lyf8118/sandiaproject/Docs/Report/Final Report/Pictures/IMG_2510.JPG

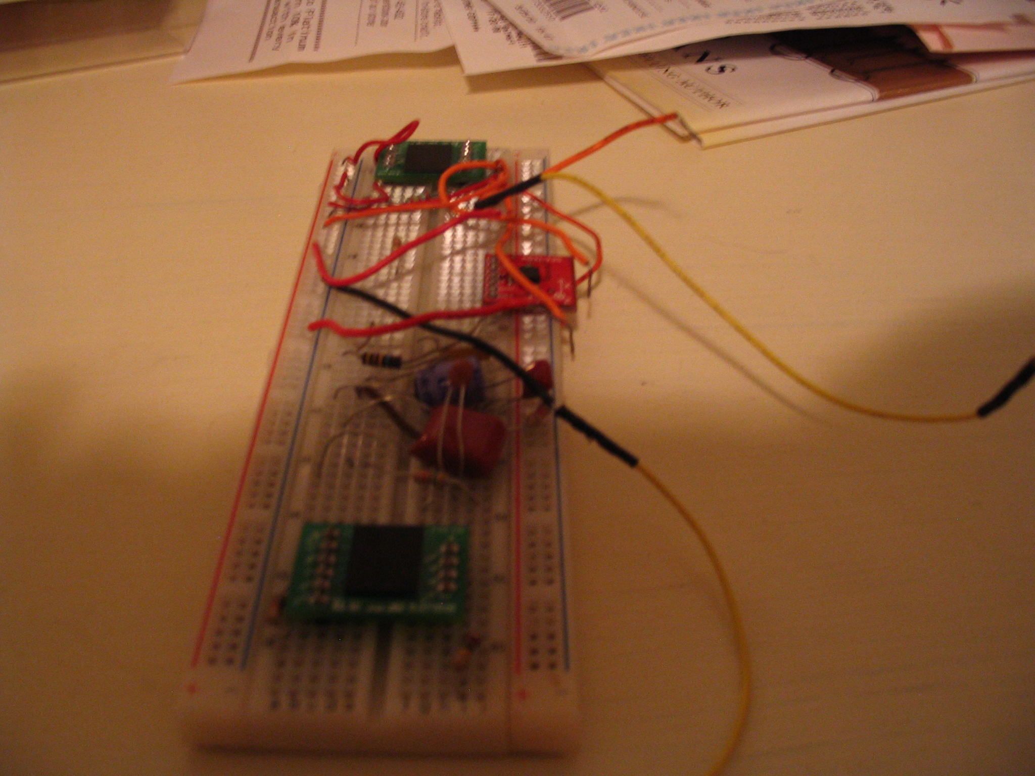
Docs/Report/Final Report/Pictures/IMG_2510.JPG
