lyf8118/sandiaproject/Docs/MSP430F5529 items/README.txt

Go to the following website to get all of the needed software for this processor. The site contains a link for software needed to run in the CCE or Kickstart programs. Make sure to install the software in the directory of your running IDE in order to make it work right.

http://focus.ti.com/docs/prod/folders/print/msp430f5529.html
