lyf8118/sandiaproject/Docs/CDs/Utah 2008-09/Paper/Abstract.docx

TESTING AND RESULTS

Eric Hsu, Daniel Rolfe, Rashin Bolkameh, Chris Chadwick, Michael

Stevens Department of Electrical and Computer Engineering, University of Utah, Salt

Lake City, UT 84112

The first step in our testing phase was to load small instruction sets to the micro controller to verify proper wiring of the board and tested for certain operation such as power, saving data, detecting movement. The testing involved verifying all individual components of our manufactured GPS stack powers up correctly and individual paths are correct in the way we envisioned. Once that phase was completed, we moved into verification logic of accelerometer code that enables and disables GPS data acquisition. One of the major aspects of our operational sequence was the transfer of data from front-end GPS unit to our internal memory and finally outputting these data using serial interface. After we verified the individual modules to be working, we combined them together to ultimately build a single overall operational code for our GPS stack. Extended testing over the GPS stack with its associated results remains the one of the primary objectives of this project.

Socket Error

Voltage Regular Drop

JTAG
