lyf8118/sandiaproject/Docs/CDs/Utah 2008-09/Paper/Visio-GPSrev1.pdf

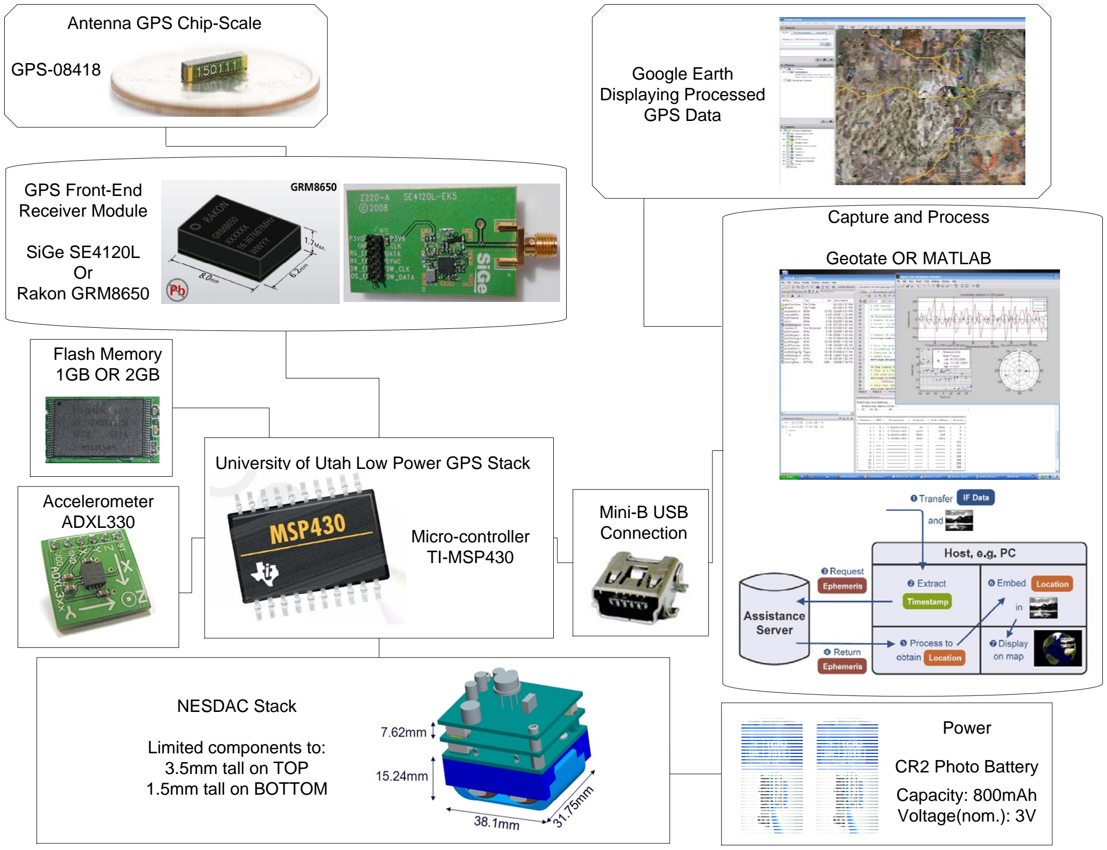
[picture p55: page 1]

Antenna GPS Chip-Scale

GPS-08418

CR2 Photo Battery
Capacity: 800mAh
Voltage(nom.): 3V

Power

NESDAC Stack

Limited components to:
3.5mm tall on TOP
1.5mm tall on BOTTOM

GPS Front-End
Receiver Module

SiGe SE4120L
Or
Rakon GRM8650

Accelerometer
ADXL330

University of Utah Low Power GPS Stack

Micro-controller
TI-MSP430

Flash Memory
1GB OR 2GB

Mini-B USB
Connection

Capture and Process

Geotate OR MATLAB

Google Earth
Displaying Processed
GPS Data
