lyf8118/sandiaproject/Docs/CDs/Utah 2008-09/Paper/Visio-GPSrev3.pdf

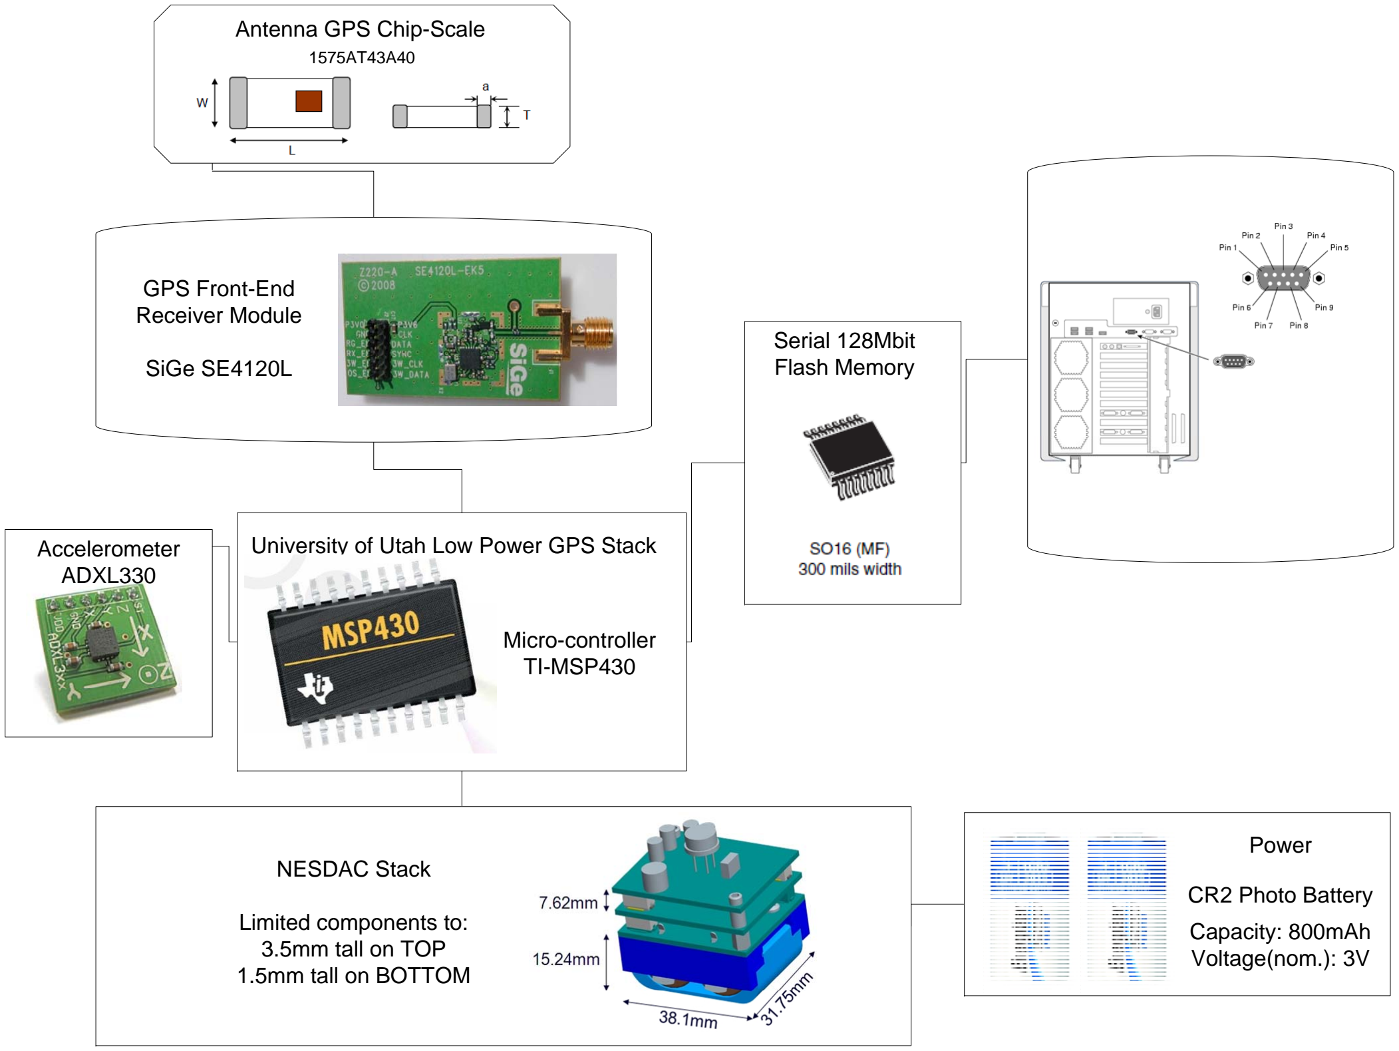
[picture p56: figure]
CR2 Photo Battery Capacity: 800mAh Voltage(nom.): 3V; Power; NESDAC Stack; Limited components to: 3.5mm tall on TOP 1.5mm tall on BOTTOM; Accelerometer ADXL330; University of Utah Low Power GPS Stack; Micro-controller TI-MSP430; Capture SERIAL Interface; Antenna GPS Chip-Scale; GPS Front-End Receiver Module; SiGe SE4120L; Serial 128Mbit Flash Memory
