lyf8118/sandiaproject/Docs/CDs/Utah 2008-09/SiGe/SE4120L-EK3/SiGe_SE4120L_CU_USBdriver/libusb-win32-device-bin-20060518/libusb-win32-device-bin-20060518/README.txt

This is libusb-win32 (http://libusb-win32.sourceforge.net) version 20060518. 
Libusb-win32 is a library that allows userspace application to access USB 
devices on Windows operation systems (Win98SE, WinME, Win2k, WinXP). 
It is derived from and fully API compatible to libusb available at 
http://libusb.sourceforge.net.

For more information visit the project's web site at:

http://libusb-win32.sourceforge.net
http://sourceforge.net/projects/libusb-win32
