lyf8118/sandiaproject/CAD/final PCB/schematic.png

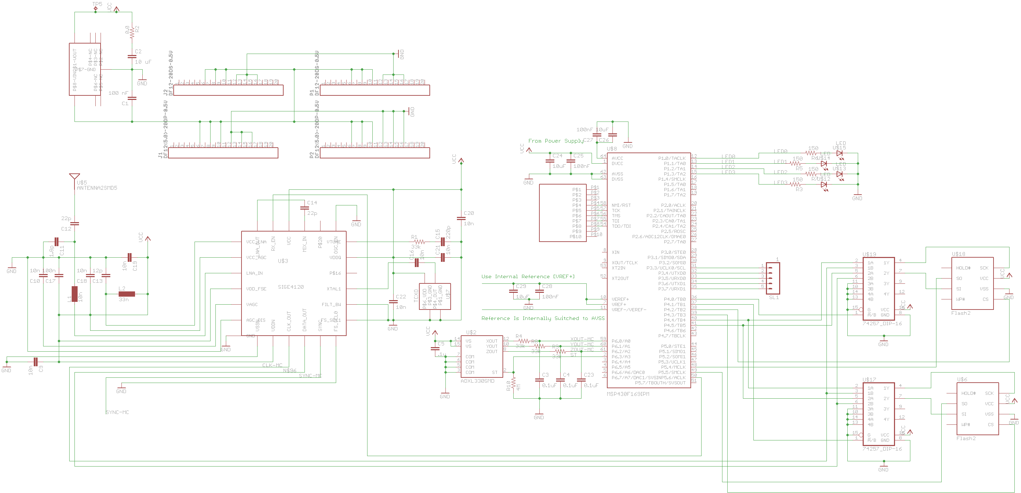
CAD/final PCB/schematic.png
