lyf8118/sandiaproject/Docs/CDs/Utah 2008-09/Misc/schematic.TIF

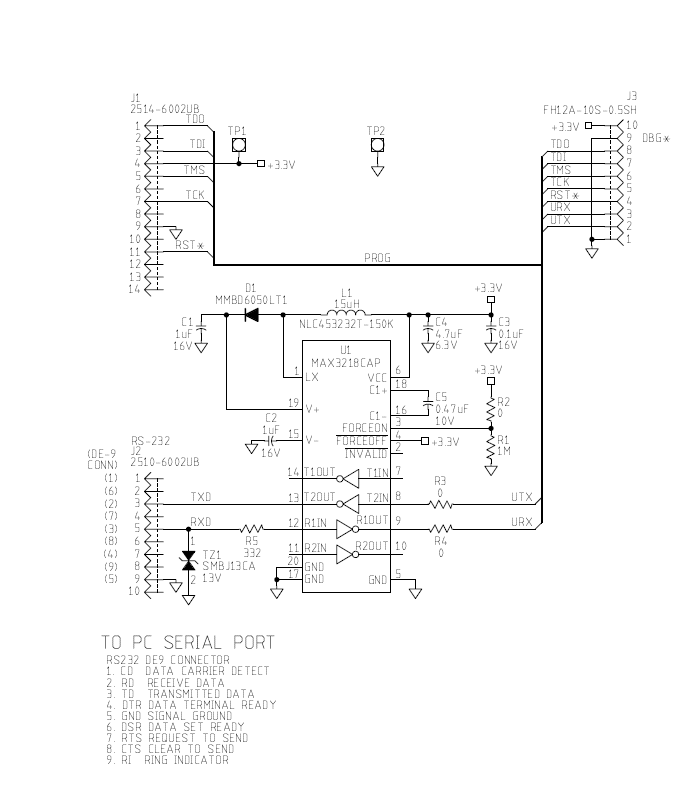
Docs/CDs/Utah 2008-09/Misc/schematic.TIF
