lyf8118/sandiaproject/Docs/CDs/Utah 2008-09/MSP430/msp430-jtag.gif

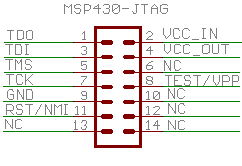
Docs/CDs/Utah 2008-09/MSP430/msp430-jtag.gif
