lyf8118/sandiaproject/Docs/CDs/Utah 2008-09/SiGe/SE4120L-EK3/Sample Captures/Mode1/Galileo/Mode1GalileoAcquire.png

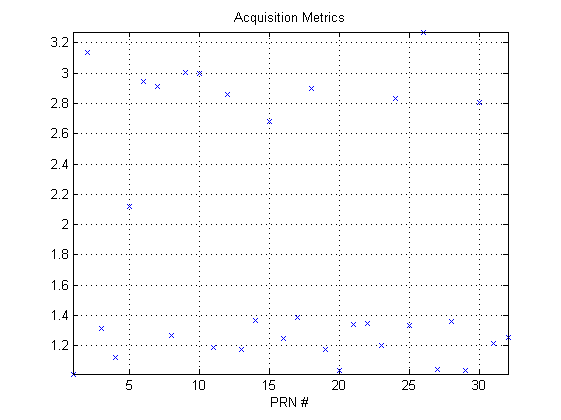
Docs/CDs/Utah 2008-09/SiGe/SE4120L-EK3/Sample Captures/Mode1/Galileo/Mode1GalileoAcquire.png
