lyf8118/sandiaproject/Docs/CDs/Utah 2008-09/SiGe/SE4120L-EK3/Sample Captures/Mode1/GPS/Mode1GPSdata.jpg

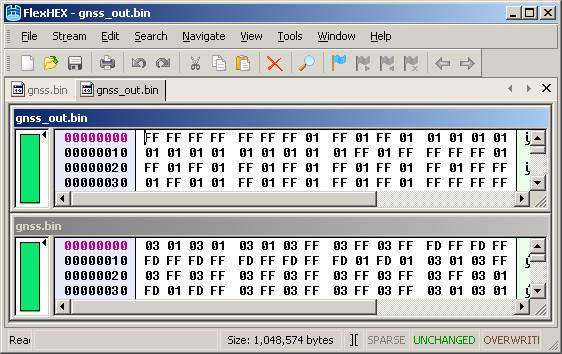
Docs/CDs/Utah 2008-09/SiGe/SE4120L-EK3/Sample Captures/Mode1/GPS/Mode1GPSdata.jpg
