lyf8118/sandiaproject/Docs/CDs/Utah 2008-09/SiGe/SE4120L-EK3/Sample Captures/Mode2/GPS/Mode2GPSdata.jpg

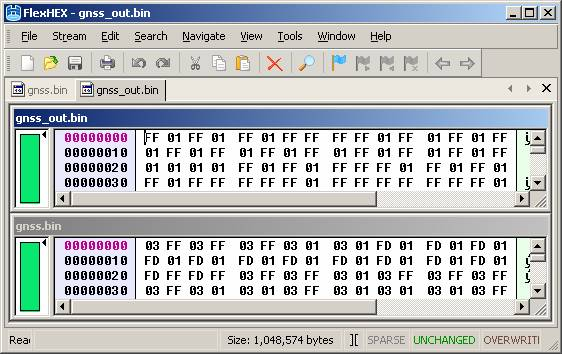
Docs/CDs/Utah 2008-09/SiGe/SE4120L-EK3/Sample Captures/Mode2/GPS/Mode2GPSdata.jpg
