lyf8118/sandiaproject/Docs/CDs/Utah 2008-09/SiGe/SE4120L-EK3/Sample Captures/Mode8/Galileo/Mode8GalileoPlots.png

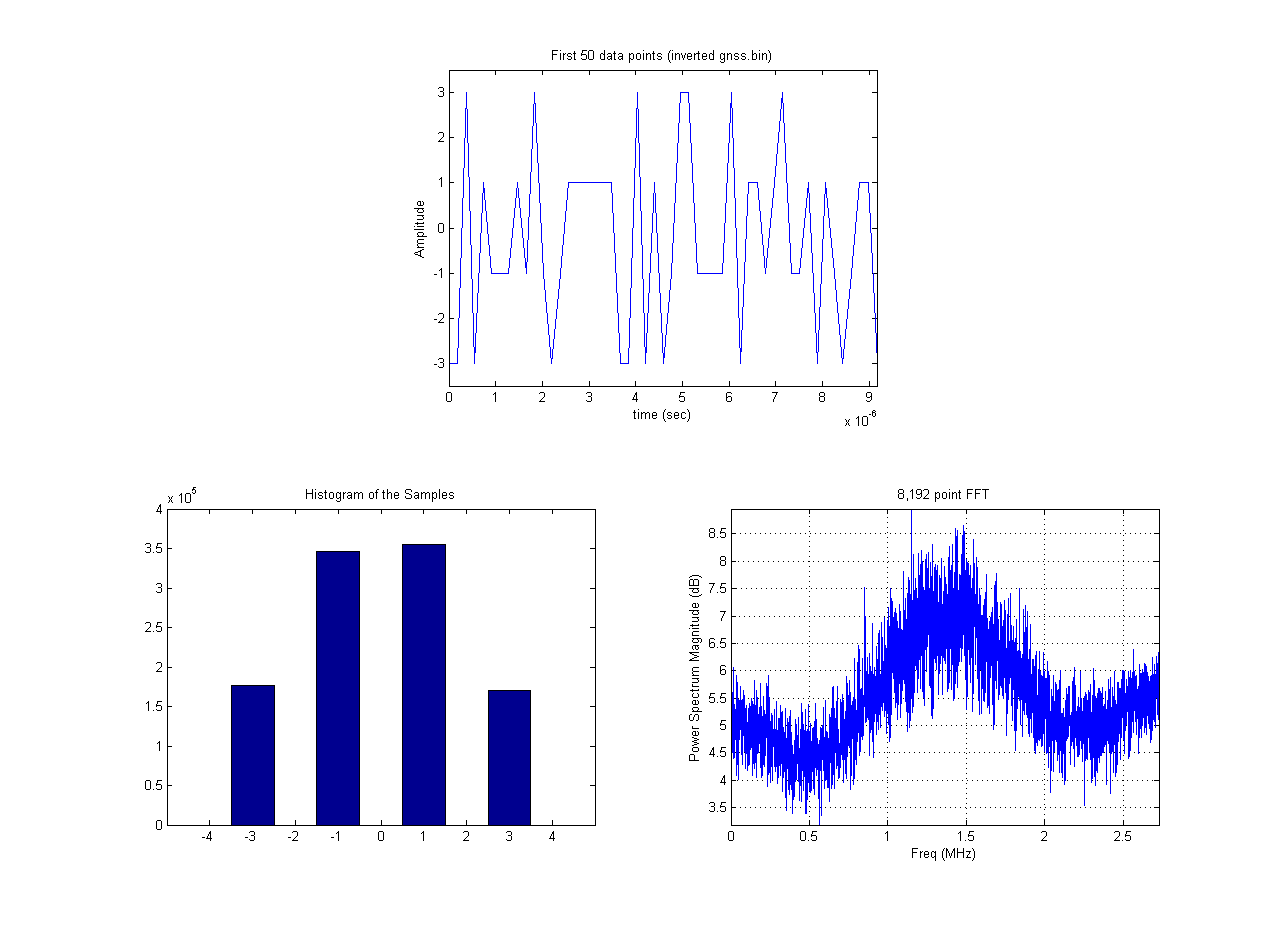
Docs/CDs/Utah 2008-09/SiGe/SE4120L-EK3/Sample Captures/Mode8/Galileo/Mode8GalileoPlots.png
