lyf8118/sandiaproject/Docs/Open House Pics/SDC10700.JPG

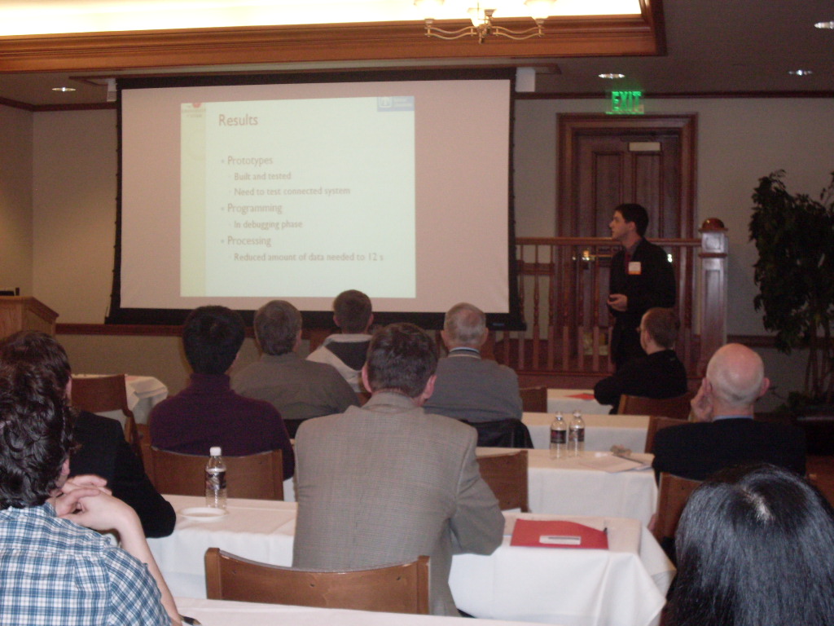
Docs/Open House Pics/SDC10700.JPG
