lyf8118/sandiaproject/Docs/Open House Pics/SDC10701.JPG

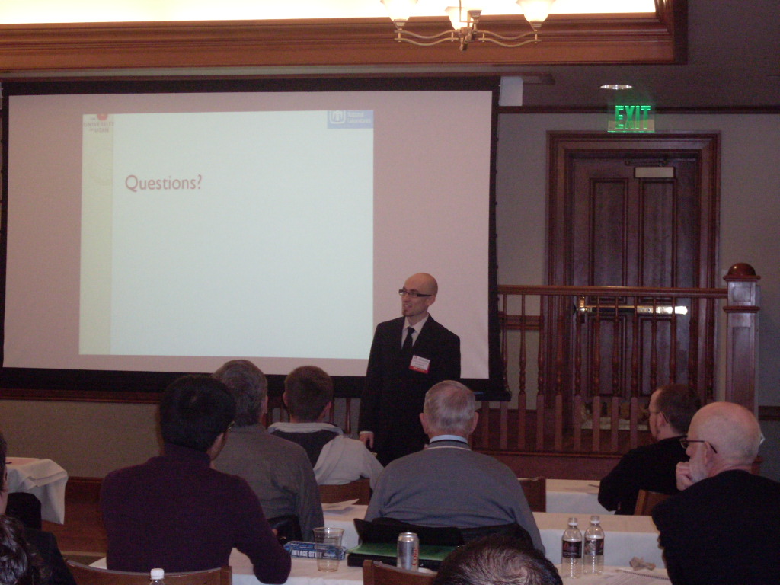
Docs/Open House Pics/SDC10701.JPG
