lyf8118/sandiaproject/Docs/Open House Pics/SDC10702.JPG

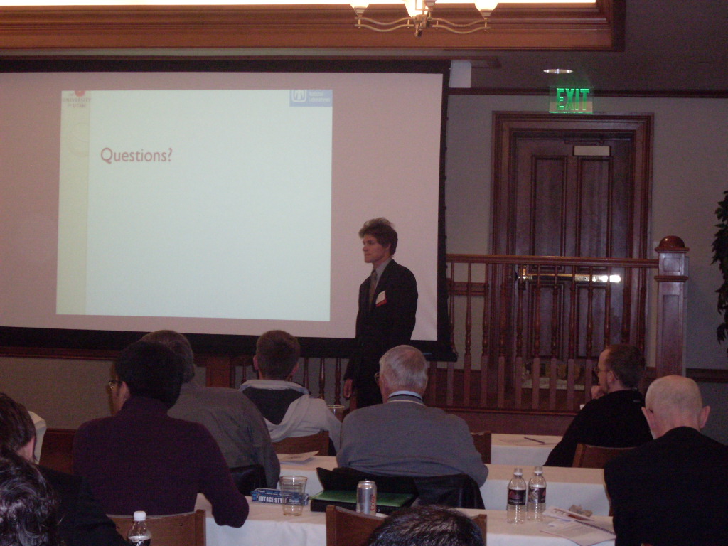
Docs/Open House Pics/SDC10702.JPG
