lyf8118/sandiaproject/Docs/Open House Pics/SDC10703.JPG

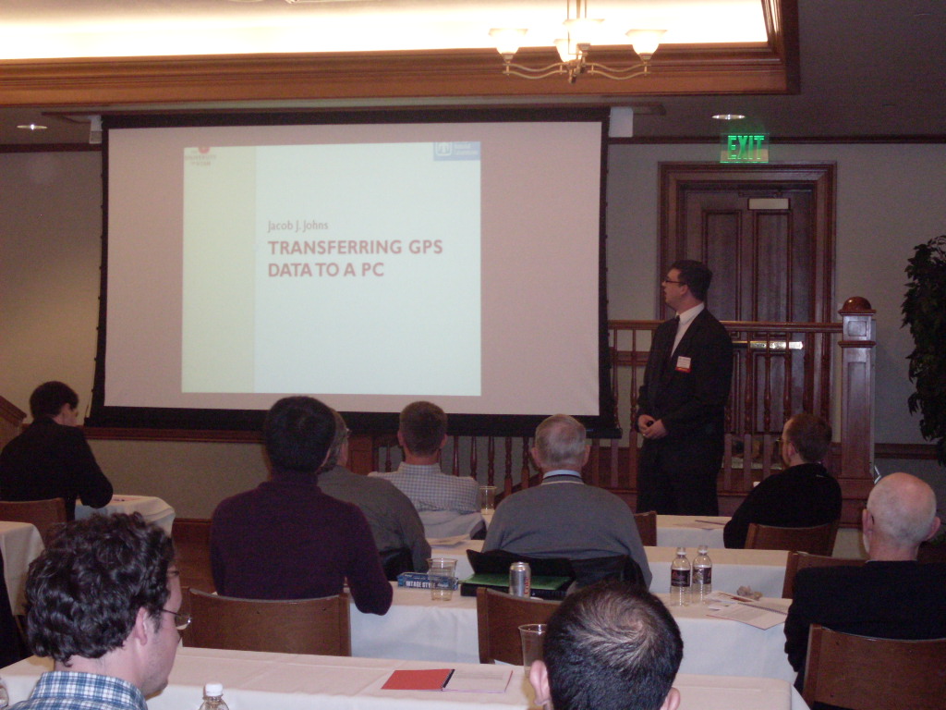
Docs/Open House Pics/SDC10703.JPG
