lyf8118/sandiaproject/Docs/Open House Pics/SDC10704.JPG

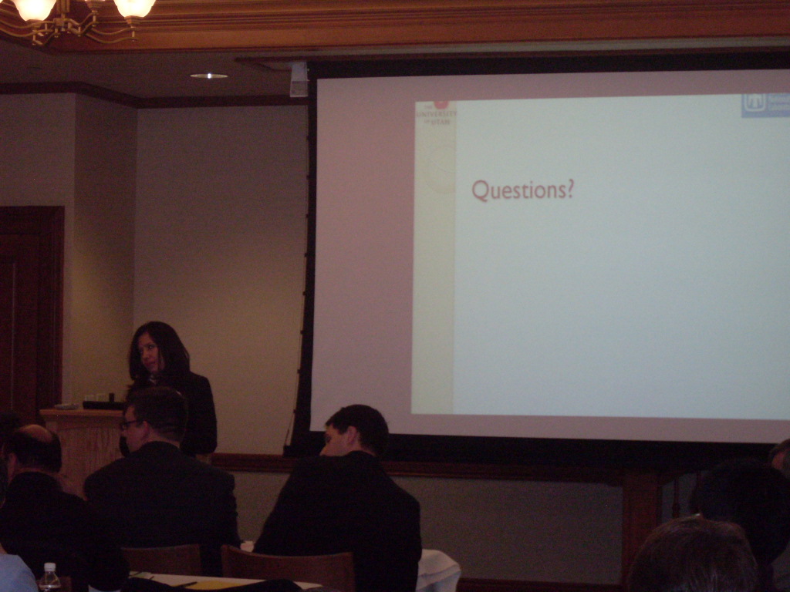
Docs/Open House Pics/SDC10704.JPG
