lyf8118/sandiaproject/Docs/Open House Pics/SDC10705.JPG

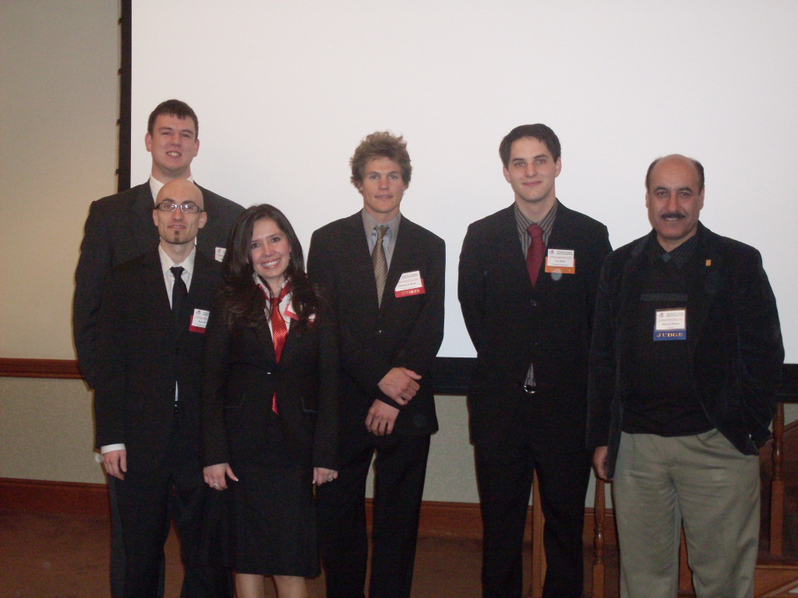
Docs/Open House Pics/SDC10705.JPG
