lyf8118/sandiaproject/Docs/Open House Pics/SDC10706.JPG

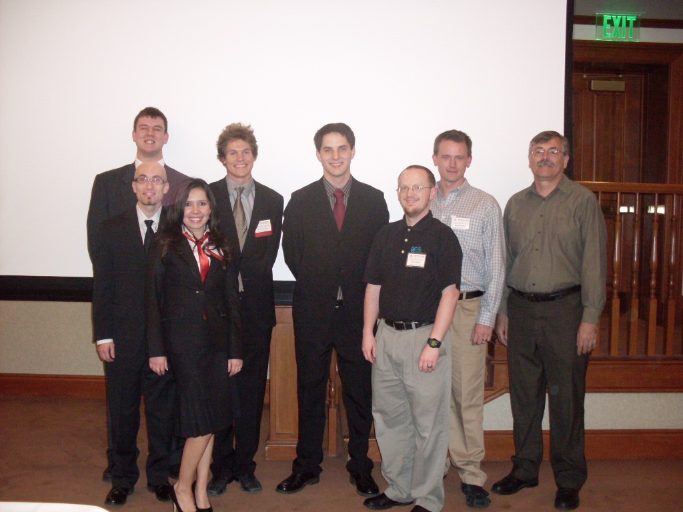
Docs/Open House Pics/SDC10706.JPG
