lyf8118/sandiaproject/Docs/Report/December Presentation/board.PNG

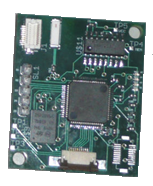
Docs/Report/December Presentation/board.PNG
