lyf8118/sandiaproject/Docs/Report/December Presentation/prototypes/flash PCB.png

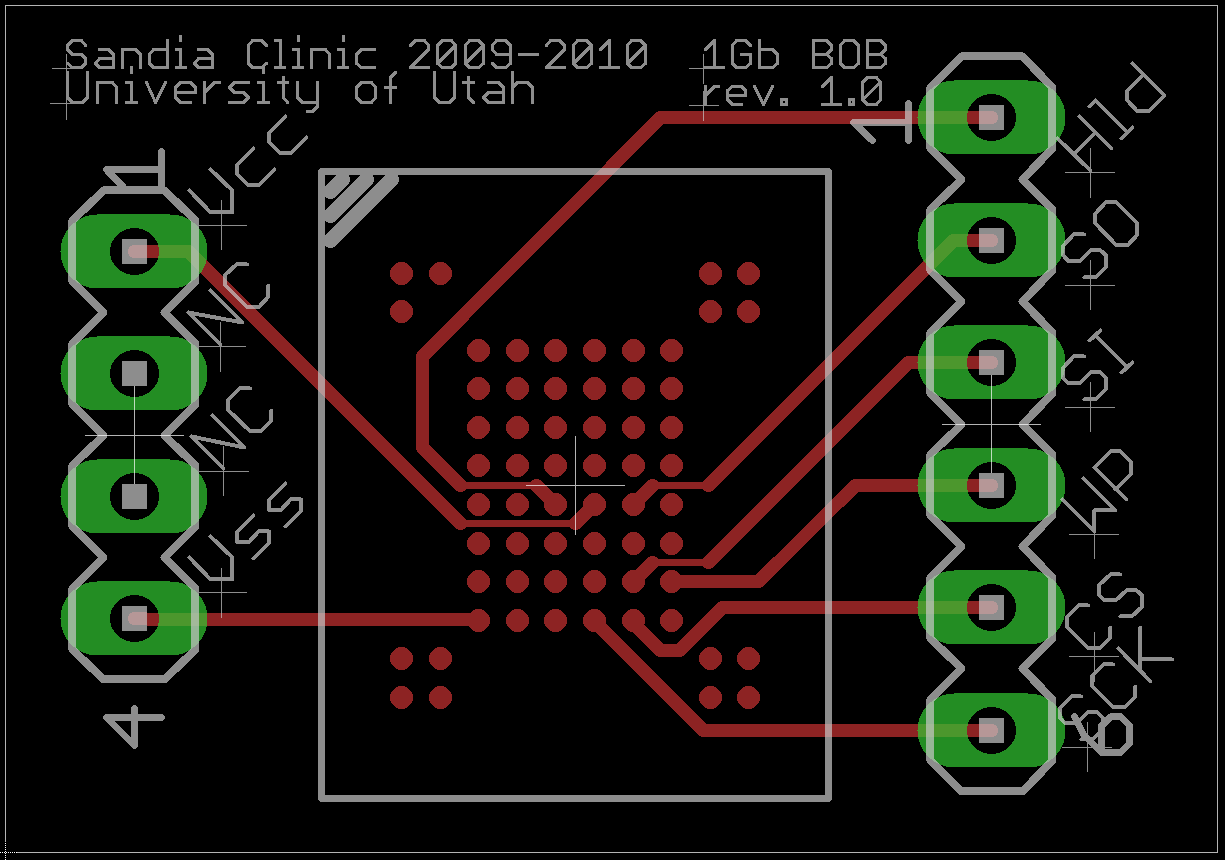
Docs/Report/December Presentation/prototypes/flash PCB.png
