lyf8118/sandiaproject/Docs/Report/December Presentation/prototypes/GPS-main-board.png

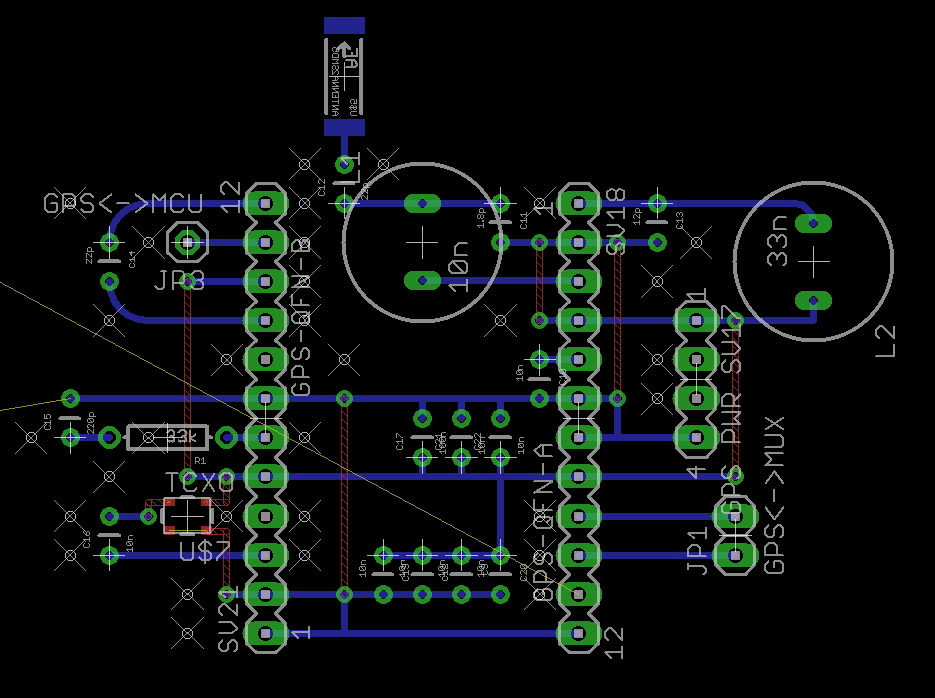
Docs/Report/December Presentation/prototypes/GPS-main-board.png
