lyf8118/sandiaproject/Docs/Report/December Presentation/prototypes/main-sch.png

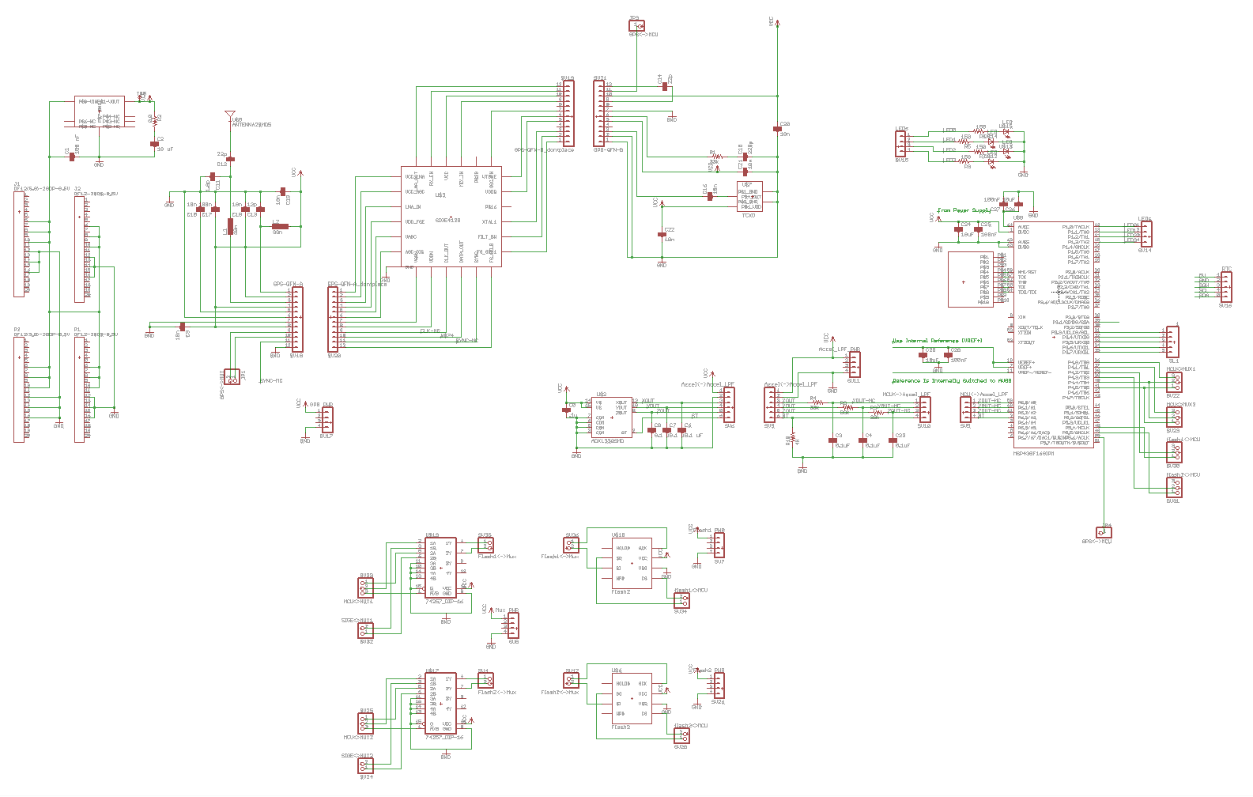
Docs/Report/December Presentation/prototypes/main-sch.png
