lyf8118/sandiaproject/Docs/Report/December Presentation/prototypes/mux-board.png

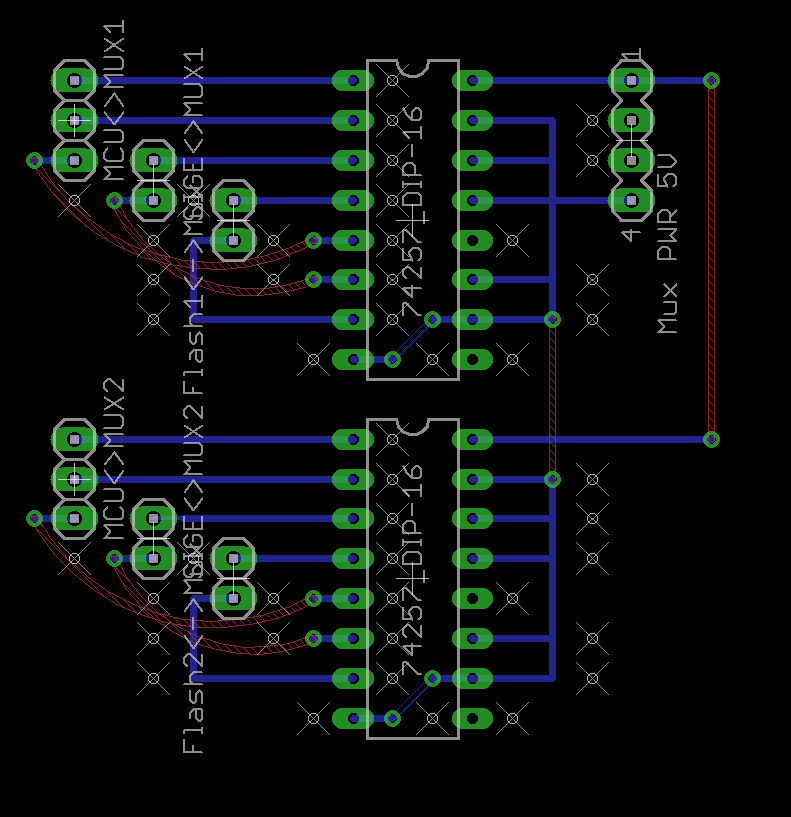
Docs/Report/December Presentation/prototypes/mux-board.png
