lyf8118/sandiaproject/Docs/Report/December Presentation/prototypes/mux-sch.png

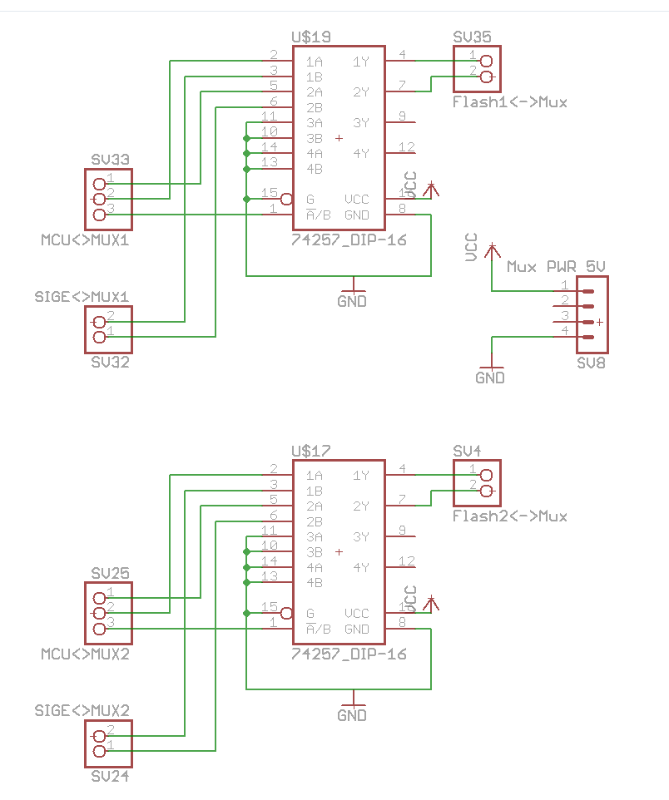
Docs/Report/December Presentation/prototypes/mux-sch.png
