lyf8118/sandiaproject/Docs/Report/Final Report/Pictures/SDC10698.JPG

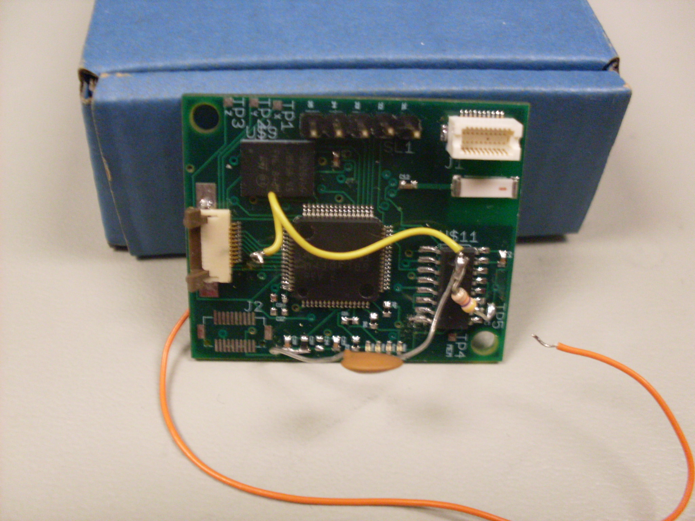
Docs/Report/Final Report/Pictures/SDC10698.JPG
