lyf8118/sandiaproject/Docs/Report/Final Report/Pictures/SDC10699.JPG

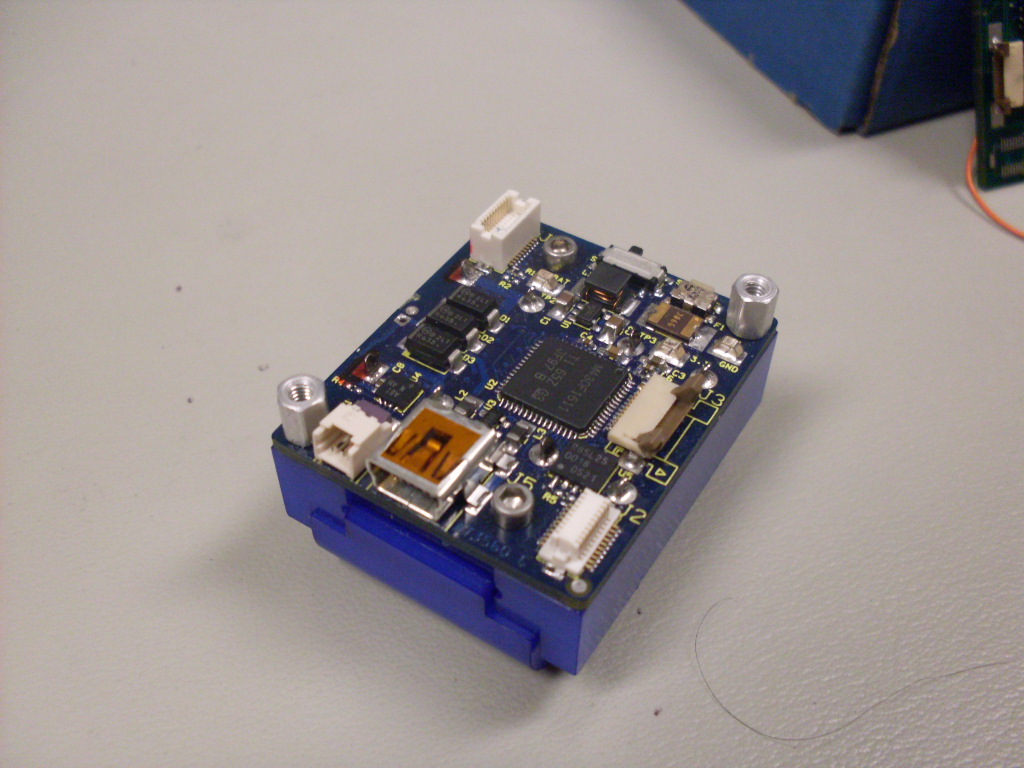
Docs/Report/Final Report/Pictures/SDC10699.JPG
