lyf8118/sandiaproject/Docs/Prototype BOM.xls

 | Parts | Part#/SKU | Per Item Cost | Quantity | Sub-Total | Form Factor | Notes/Link:
 | Breakout Boards:
√ | Accelerometer | SEN-00692 | $24.95 | 3 | $74.85 | Break-out w/ Pin Header | http://www.sparkfun.com/commerce/product_info.php?products_id=9269
√ | Real-time clock module | BOB-00099 | $19.95 | 3 | $59.85 | Break-out w/ Pin Header | http://www.sparkfun.com/commerce/product_info.php?products_id=99
 | ICs:
√ | 1Gbit serial NAND flash | MT29F1G01ZACHC-ET:C | $6.56 | 10 | $65.60 | 63VFBGA | http://avnetexpress.avnet.com/store/em/EMController/_/A-8960004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
 | Quad 2-input mux | 74ACT257PC | $0.59 | 5 | $2.95 | DIP16 | http://www.mouser.com/ProductDetail/Fairchild-Semiconductor/74ACT257PC/?qs=yRUxxYa83chaGrYYKp2KnA%3d%3d
√ | SiGe GNSS receiver | SE4120L-R | $1e-06 | 5 | $5e-06 | 24QFN | SiGe test samples provided free of cost
√ | Test board for MSP430F5529 | MSP-TS430PN80USB | $75.00 | 1 | $75.00 |  | Test board for new processor, includes new processor
 | 16.368Mhz VCTCXO |  | $8.13 | 10 | $81.30 | SMD | http://search.digikey.com/scripts/DkSearch/dksus.dll?Detail?name=535-9615-1-ND
 | Misc components:
√ | Stripboard (large) |  | $1.95 | 2 | $3.90 | 110x94mm | http://www.futurlec.com/ProtoBoards.shtml
√ | Stripboard (small) |  | $0.95 | 10 | $9.50 | 94x53mm | http://www.futurlec.com/ProtoBoards.shtml
√ | SMA connector | WRL-00593 | $1.95 | 3 | $5.85 | PCB edge mount | http://www.sparkfun.com/commerce/product_info.php?products_id=593
 | Passive components |  | $20.00 | 1 | $20.00 |  | UofU parts dept.
 | Pin headers |  | $0.75 | 20 | $15.00 | Square, .1" pitch, through-hole | UofU parts dept.
 | Ribbon cables, wire |  | $20.00 | 1 | $20.00 |  | UofU parts dept.
√ | QFN Schmart board | 202-0016-01 | $9.99 | 3 | $29.97 |  | http://www.schmartboard.com/index.asp?page=products_csp&id=74
√ | Mechanical Bridge (x20) | 920-0003-01 | $5.00 | 1 | $5.00 |  | http://www.schmartboard.com/index.asp?page=products_jch&id=23
√ | 2" jumpers and headers |  | $5.00 | 2 | $10.00 |  | http://www.schmartboard.com/index.asp?page=products_jch&id=112
√ | 3" jumpers and headers |  | $5.00 | 1 | $5.00 |  | http://www.schmartboard.com/index.asp?page=products_jch&id=112
√ | T.H. Power And Gnd Strip | 201-0100-01 | $2.50 | 2 | $5.00 |  | http://www.schmartboard.com/index.asp?page=products_io&id=12
√ | M3 nuts and screws 12-pack | STOFFHEX_15MM | $2.20 | 4 | $8.80 |  | http://www.futurlec.com/Hardware.shtml
√ | SD/MMC breakout board | BOB-00204 | $17.95 | 1 | $17.95 |  | http://www.sparkfun.com/commerce/product_info.php?products_id=204
√ | Breakaway female pin-header | PRT-00115 | $1.50 | 2 | $3.00 |  | http://www.sparkfun.com/commerce/product_info.php?products_id=115
 | Flash breakout PCB | custom | $15.00 | 10 | $150.00 | PCB | Quick Turn Circuits, 122 South Navajo Street, Salt Lake City, UT 84104
 | Est. shipping/tax/labor
√ | Schmartboard.com |  | $15.65 | 1 | $15.65
√ | Futurelec.com |  | $22.00 | 1 | $22.00
√ | SparkFun |  | $8.29 | 1 | $8.29
√ | avnet.com |  | $8.00 | 1 | $8.00
 | Flash breakout PCB Assembly |  | $30.00 | 10 | $300.00
 | Total |  |  |  | $1022.46
 | Completed Order Total |  |  |  | $514.51
( √ shows received parts)
