lyf8118/sandiaproject/Docs/CDs/Utah 2008-09/Misc/Parts.xlsx

Components | Part # | Development Board | Eagle | Misc Parts | Documents
uProcessor | Texas Instrument (msp430f169) | X | X |  | TI\msp430f169.pdf
GPS | SE4120L | X | X | X | DATA\SE4120L GNSS Receiver IC Datasheet.pdf
Antenna | 1575AT43A40E | Not Needed/Make |  |  | DATA\JTI_Antenna-1575AT43A40_2006-09.pdf
 | http://search.digikey.com/scripts/DkSearch/dksus.dll?Detail?name=712-1003-6-ND |  |  |  | DATA\JTI_Antenna-Packaging_5-04.pdf
Accelerometer | ADXL330 | X | X |  | DATA\ADXL330_0.pdf
 |  | http://www.sparkfun.com/commerce/product_info.php?products_id=692
Flash Memory | PRT-00127 | Order | X | NA | DATA\microSD_Spec.pdf
 | http://www.sparkfun.com/commerce/product_info.php?products_id=127 | http://www.sparkfun.com/commerce/product_info.php?products_id=544
Power Regulator | LM2936 | Waiting | X | X | DATA\LM2936MM.pdf
Connectors Receptacle | DF12-20DS-0.5V (86) | ASK | x | NA | DATA\e53700036.pdf
 | http://search.digikey.com/scripts/DkSearch/dksus.dll?Detail?name=H5209CT-ND
Connector Header | DF12 (5.0)-20DP-0.5V (86) | ASK | x | NA | DATA\LP5996.pdf
 | http://search.digikey.com/scripts/DkSearch/dksus.dll?Detail?name=H5244CT-ND
16.368MHz Crystal Oscillators | ASVTX-11-A-16.368MHZ-T |  | X
 | http://search.digikey.com/scripts/DkSearch/dksus.dll?Detail?name=535-9615-1-ND
25MHz Crystal Oscillators | SG-310SCF 25.0000MB3
 | http://search.digikey.com/scripts/DkSearch/dksus.dll?Detail?name=SER3652CT-ND
Quad 2-Input Multiplexer | Fairchild 74AC257 |  | X |  | DATA\74ACT257.pdf
Serial Flash | M25P128 |  | X |  | DATA\M25P128.pdf
