lyf8118/sandiaproject/Docs/CDs/Utah 2008-09/DATA/ADXL3xx-Breakout.pdf

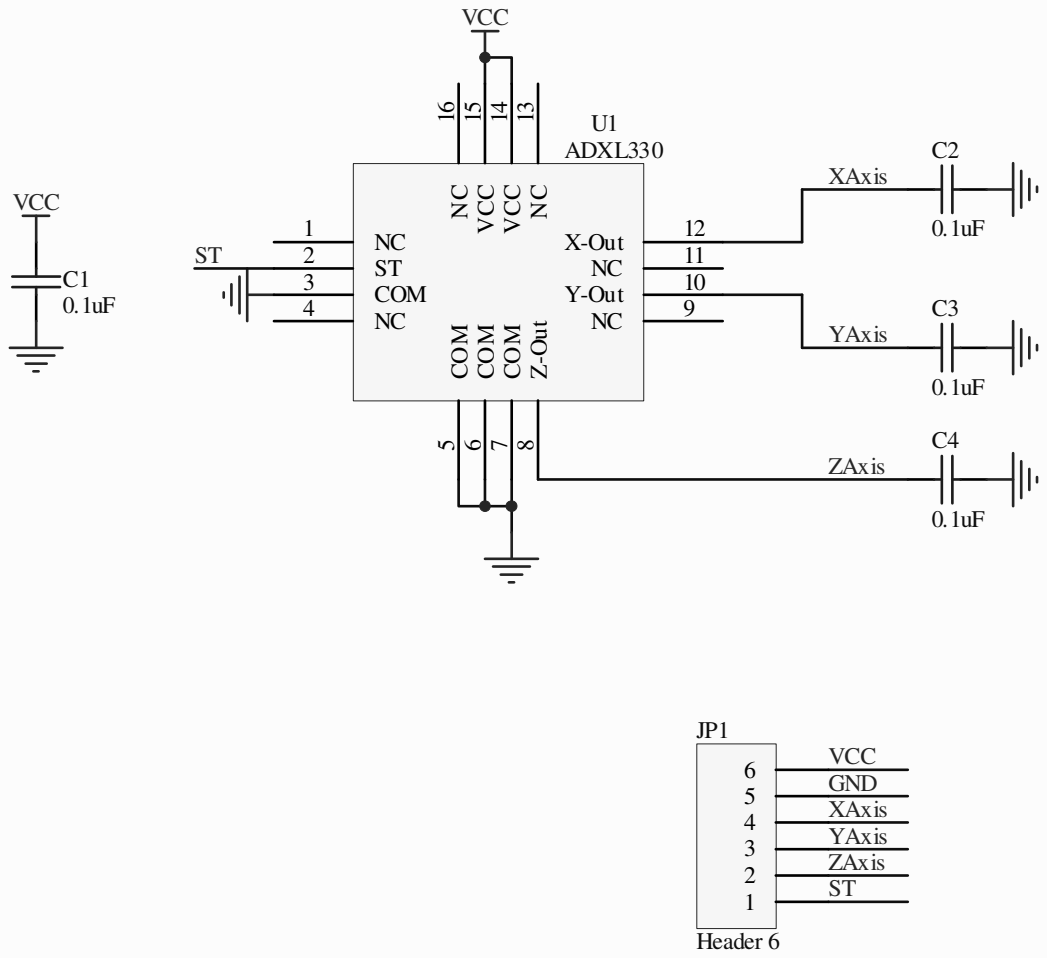
[picture p130: page 1]
Title; Size; Number; Revision; Date:; Sheet of; File:; C:\Global\..\ADXL Layout-3xx.Sch; Drawn By:; XAxis YAxis; GND; VCC; ADXL3xx Layout; XAxis; YAxis; Spark Fun Electronics; 9 COM 3; Y-Out; 11 X-Out V; ADXL330; ZAxis; Header 6
