lyf8118/sandiaproject/Docs/CDs/Utah 2008-09/Paper/New/CK-A73560-C-SCH-WIP3-UNC.pdf

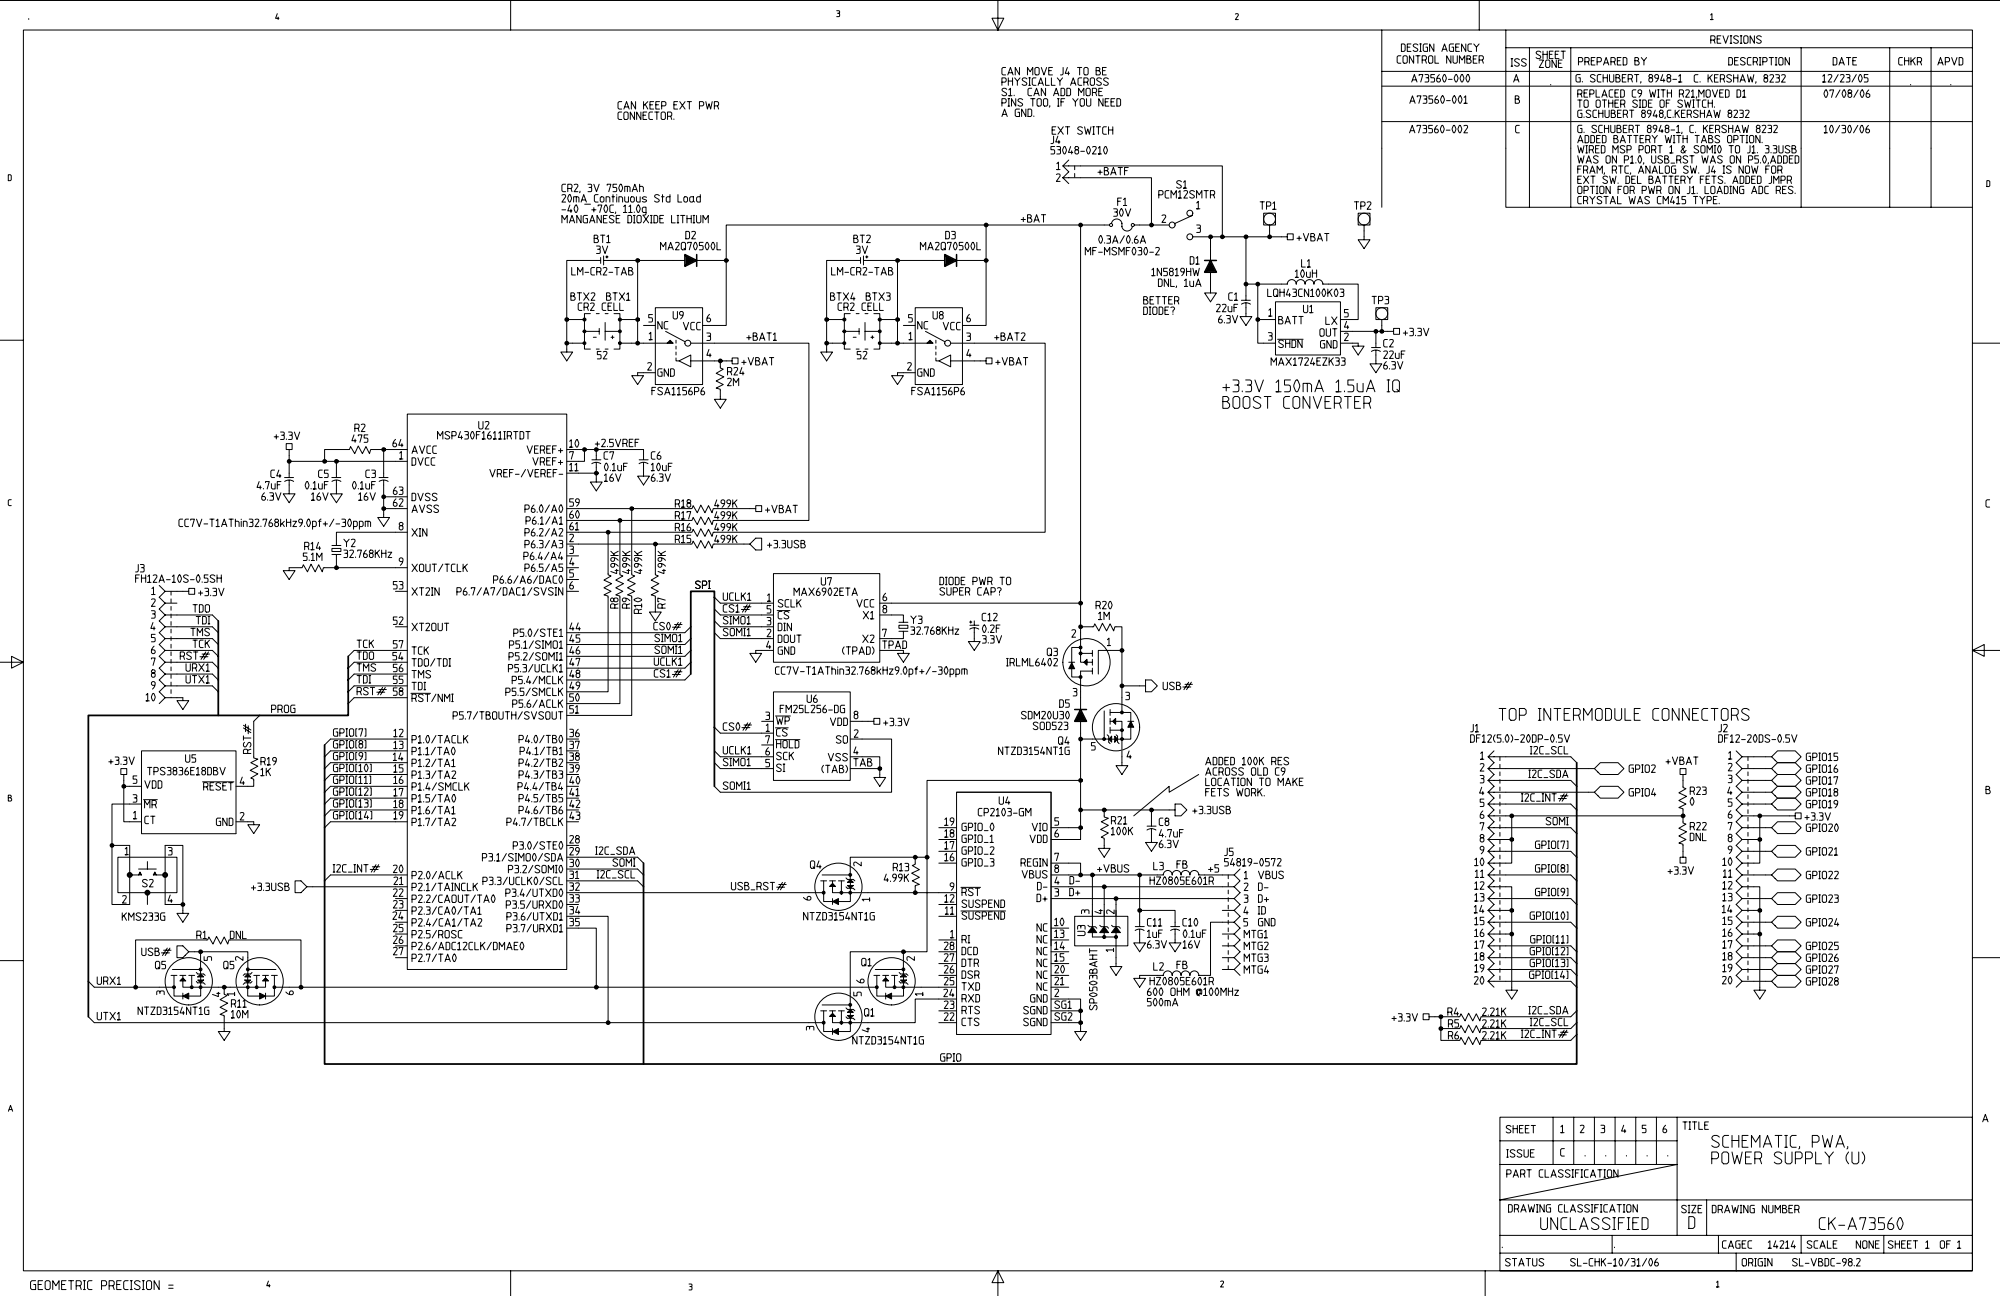
[picture p131: page 1]

DESIGN AGENCY
ISS ZONE CONTROL NUMBER

CAN MOVE J4 TO BE
PHYSICALLY ACROSS
S1. CAN ADD MORE
PINS TOO, IF YOU NEED
A GND.

REPLACED C9 WITH R21,MOVED D1
TO OTHER SIDE OF SWITCH.
G.SCHUBERT 8948,C.KERSHAW 8232

CAN KEEP EXT PWR
CONNECTOR.

ADDED BATTERY WITH TABS OPTION.
WIRED MSP PORT 1 & SOMI0 TO J1. 3.3USB
WAS ON P1.0, USB_RST WAS ON P5.0,ADDED
FRAM, RTC, ANALOG SW. J4 IS NOW FOR
EXT SW. DEL BATTERY FETS. ADDED JMPR
OPTION FOR PWR ON J1. LOADING ADC RES.
CRYSTAL WAS CM415 TYPE.
