lyf8118/sandiaproject/Docs/MSP430F5529 items/USB Sample Kit/Getting Started & Support Files/MSP430 USB Design - Support documents/MSP-TS430PN80USB Board Schematic.pdf

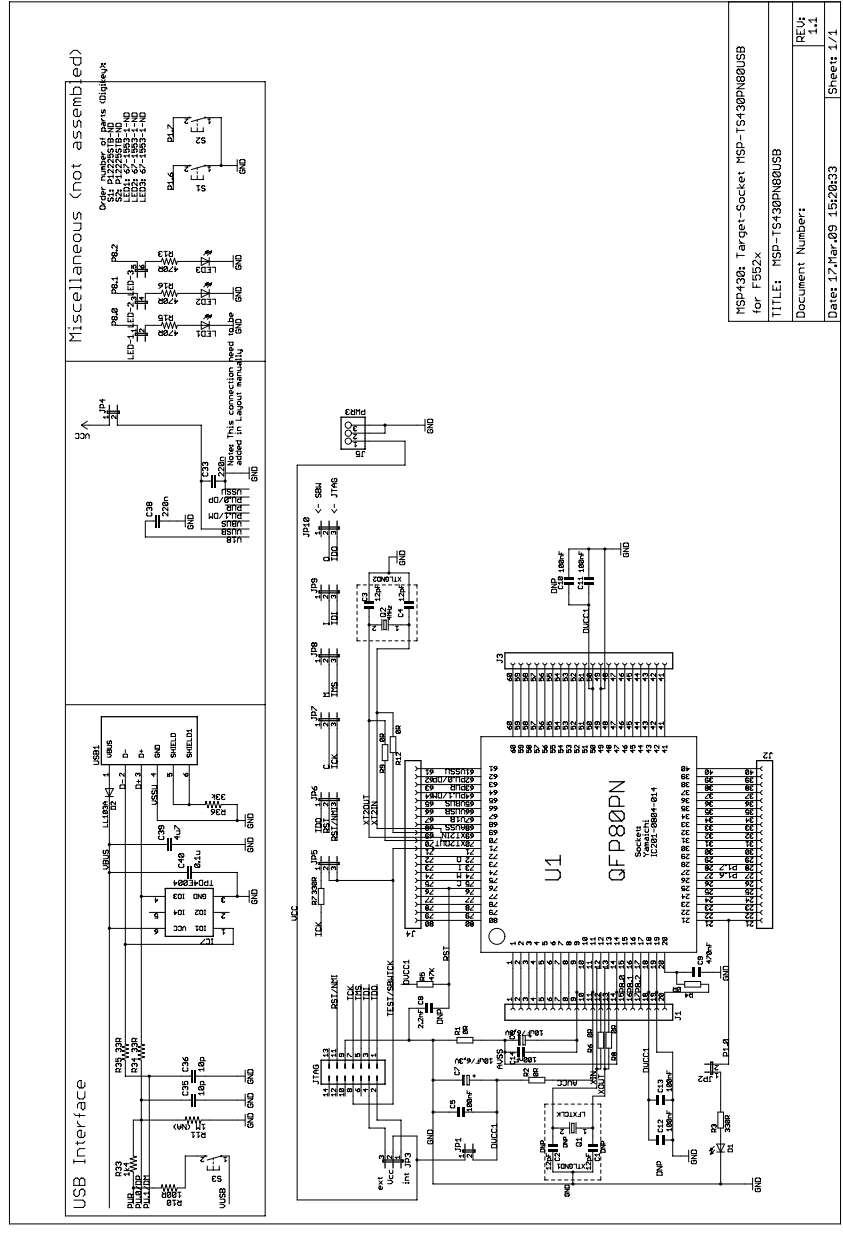
[picture p132: page 1]

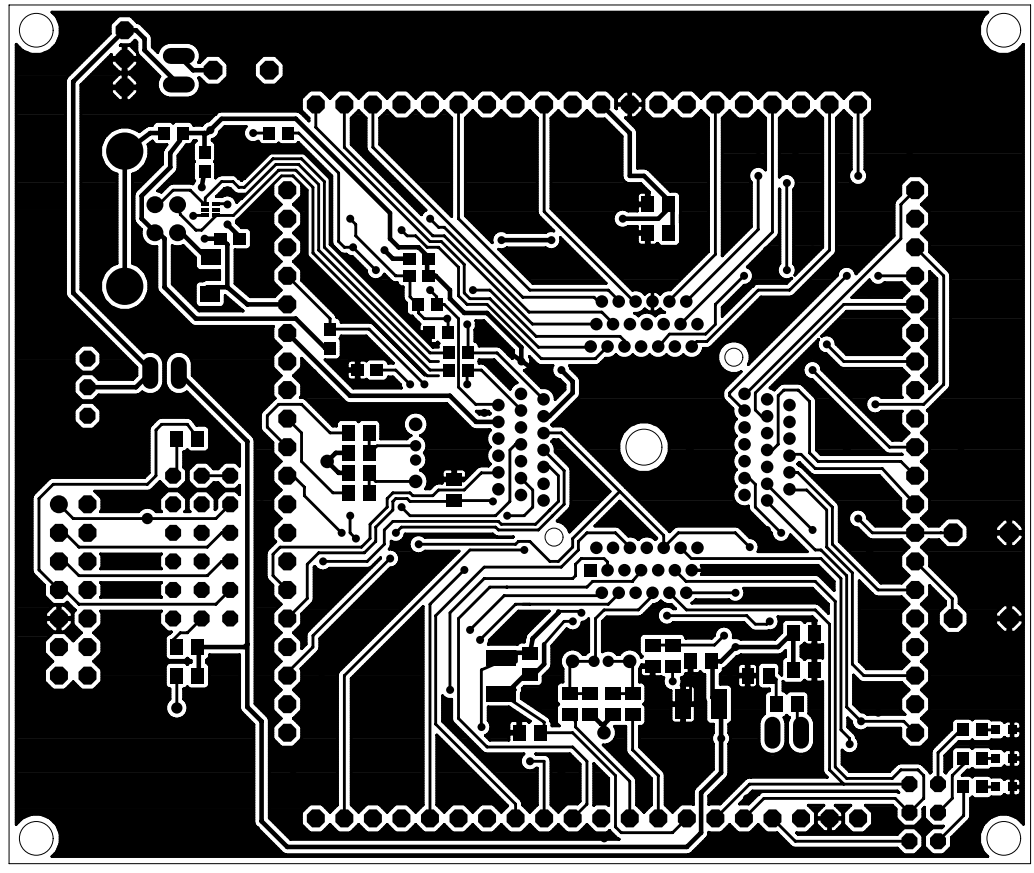
[picture p133: page 2]

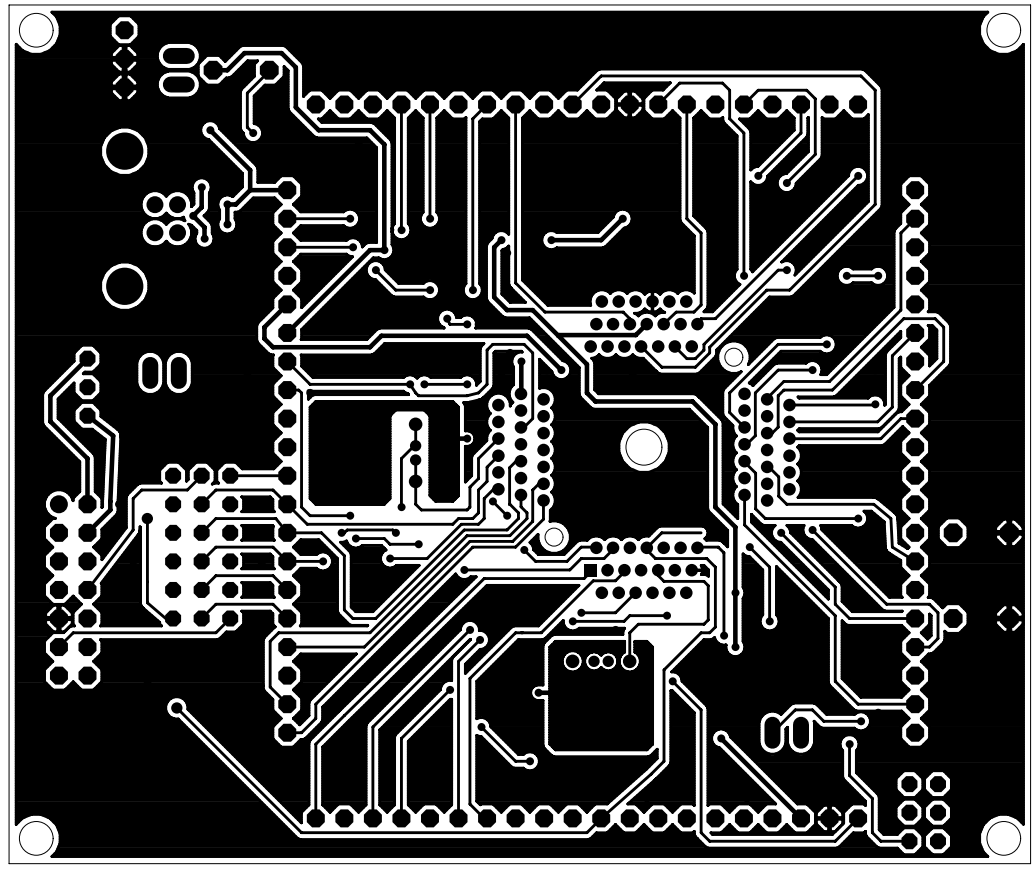
[picture p134: page 3]

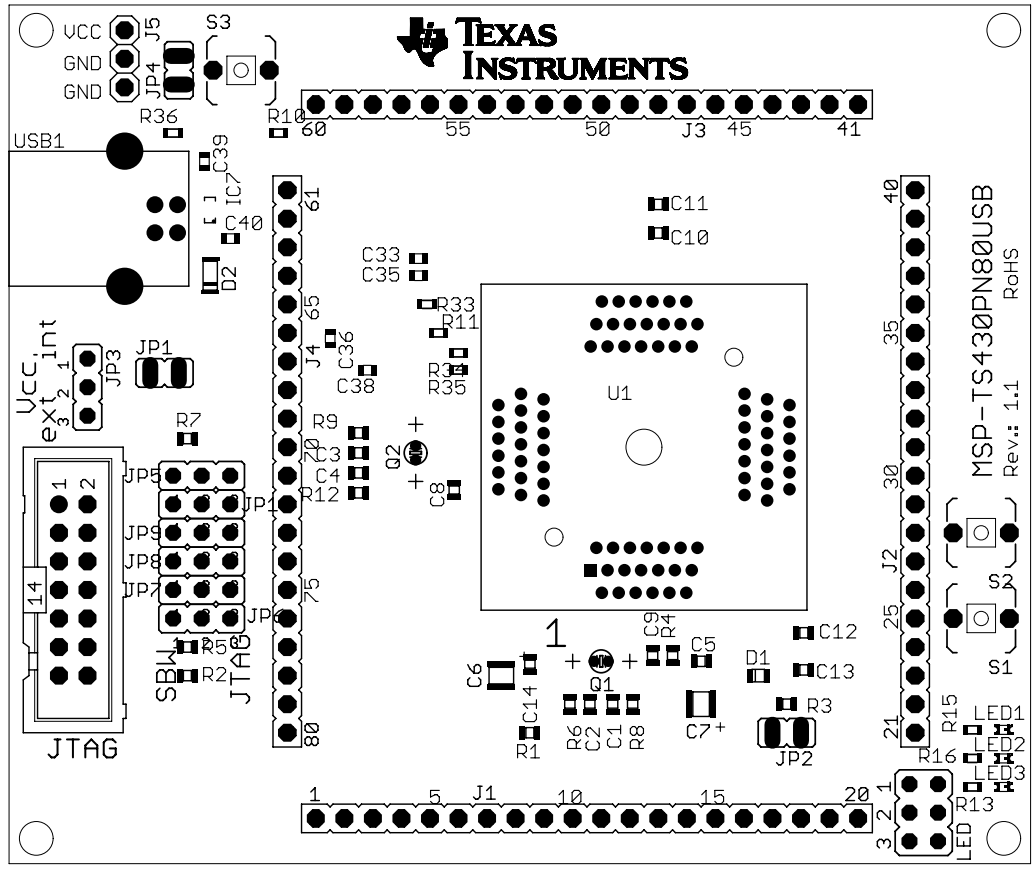
[picture p135: page 4]

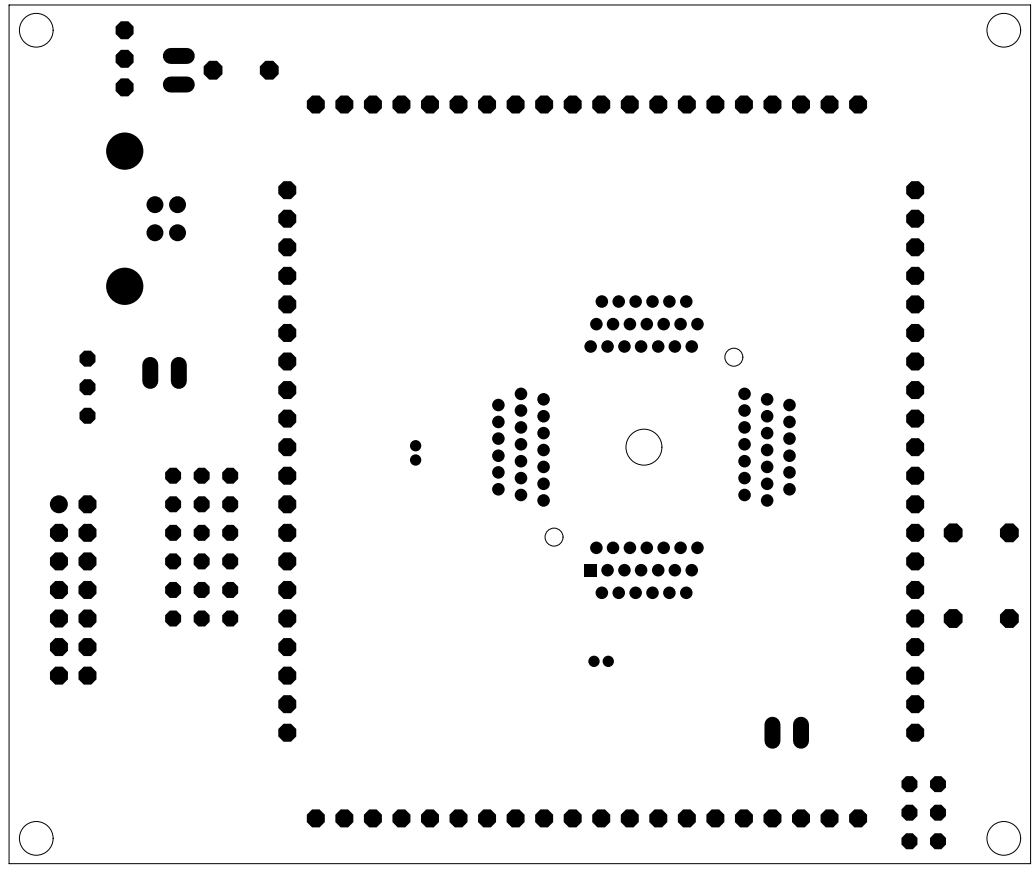
[picture p136: page 5]

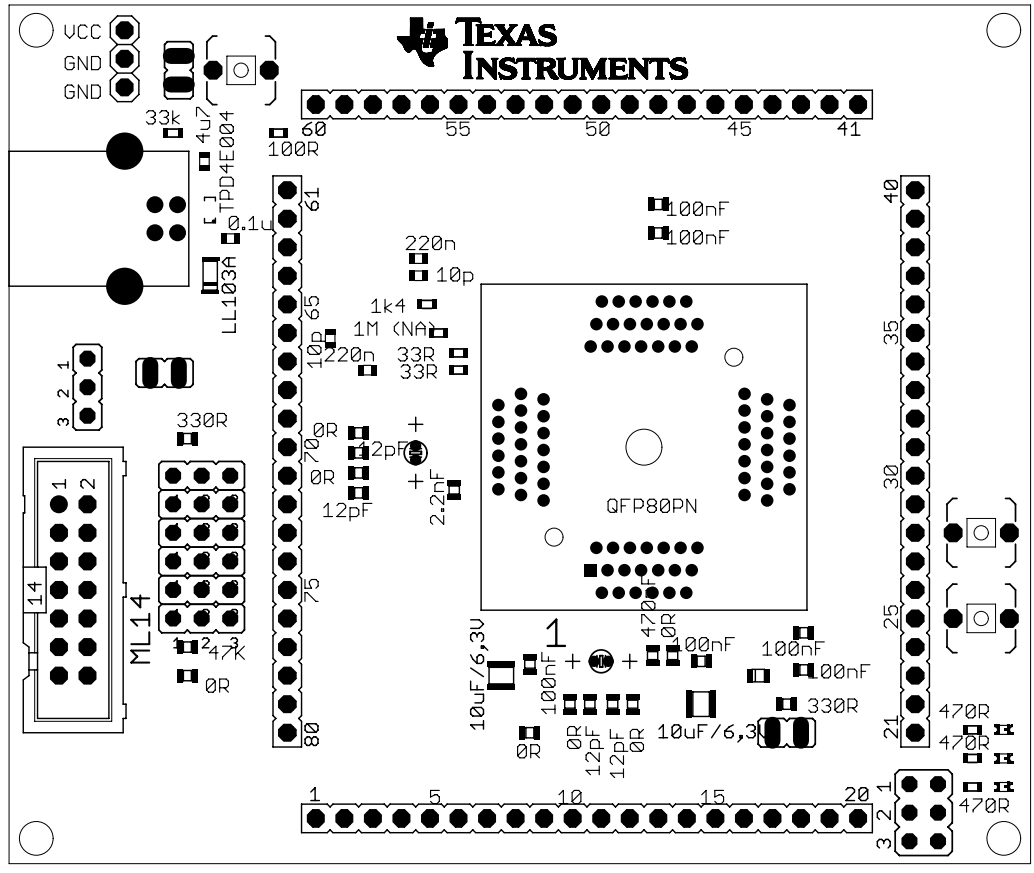
[picture p137: page 6]
