lyf8118/sandiaproject/Docs/CDs/Utah 2008-09/MSP430/FLOW CHART.pdf

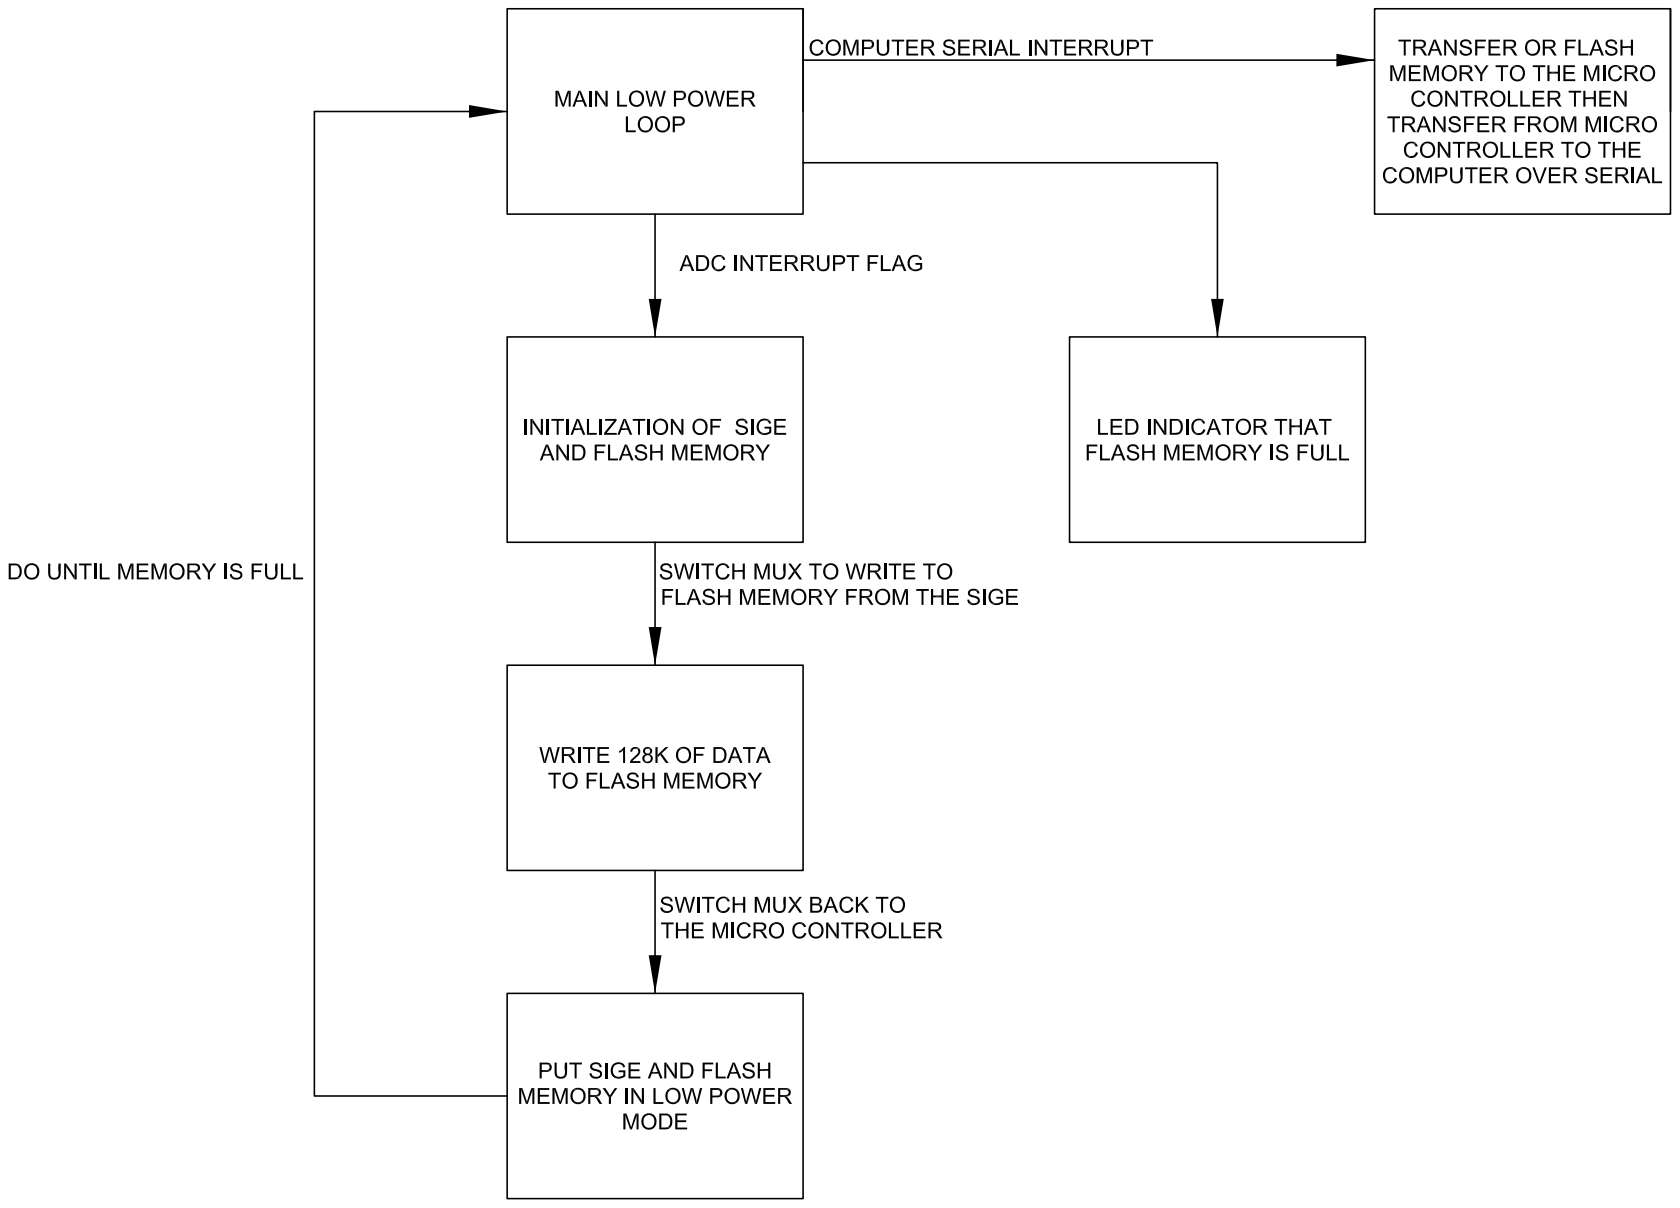
[picture p138: page 1]
