lyf8118/sandiaproject/Docs/CDs/Utah 2009-10/Background info/NESDAC PCB Footprint.pdf

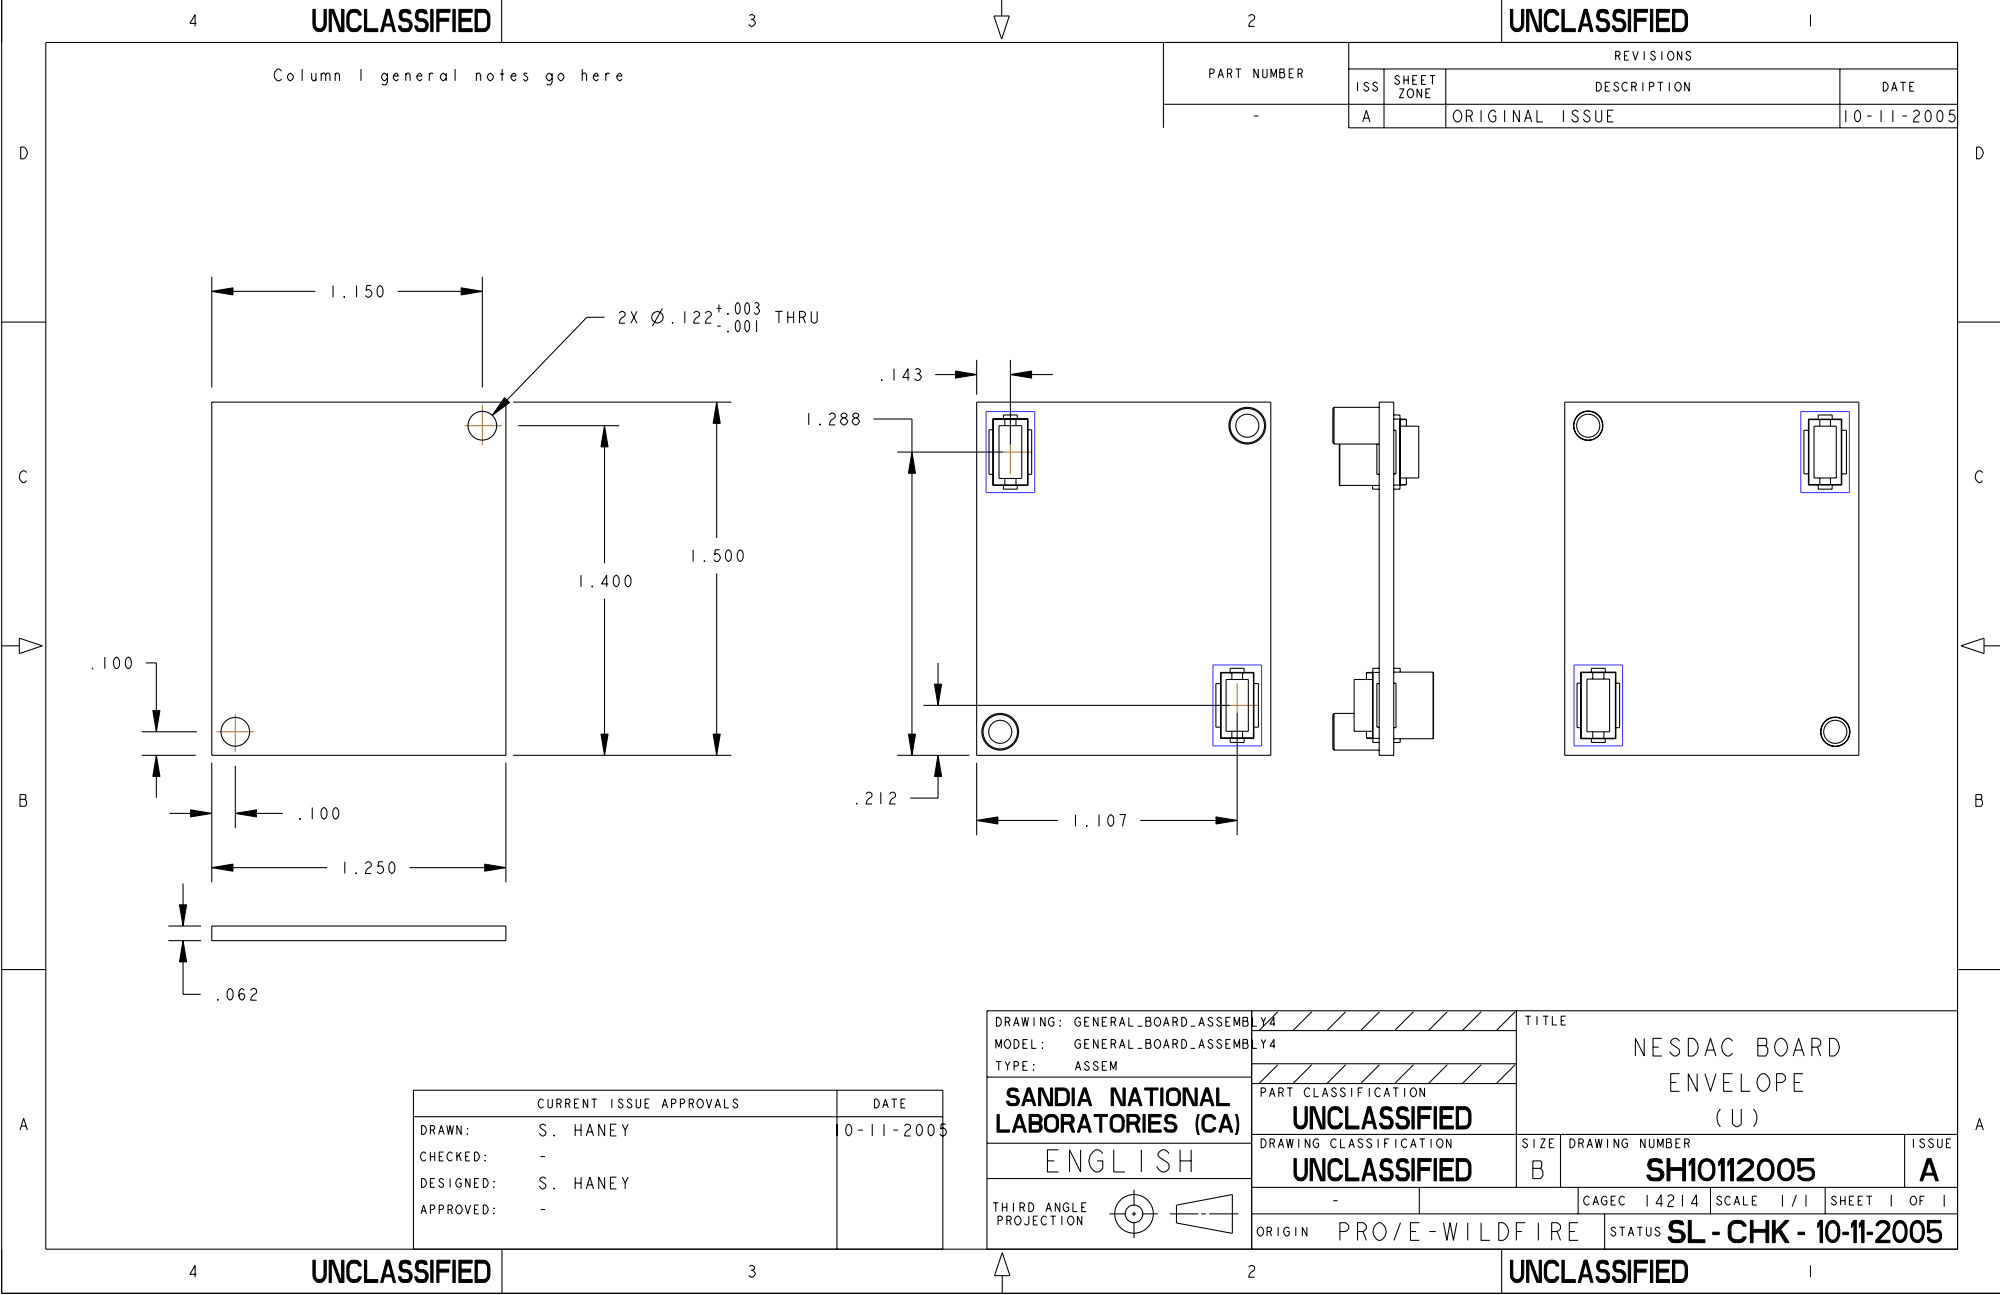
[picture p139: page 1]
