lyf8118/sandiaproject/Docs/CDs/Utah 2008-09/Paper/New/RD0151_Rev4.pdf

D

D

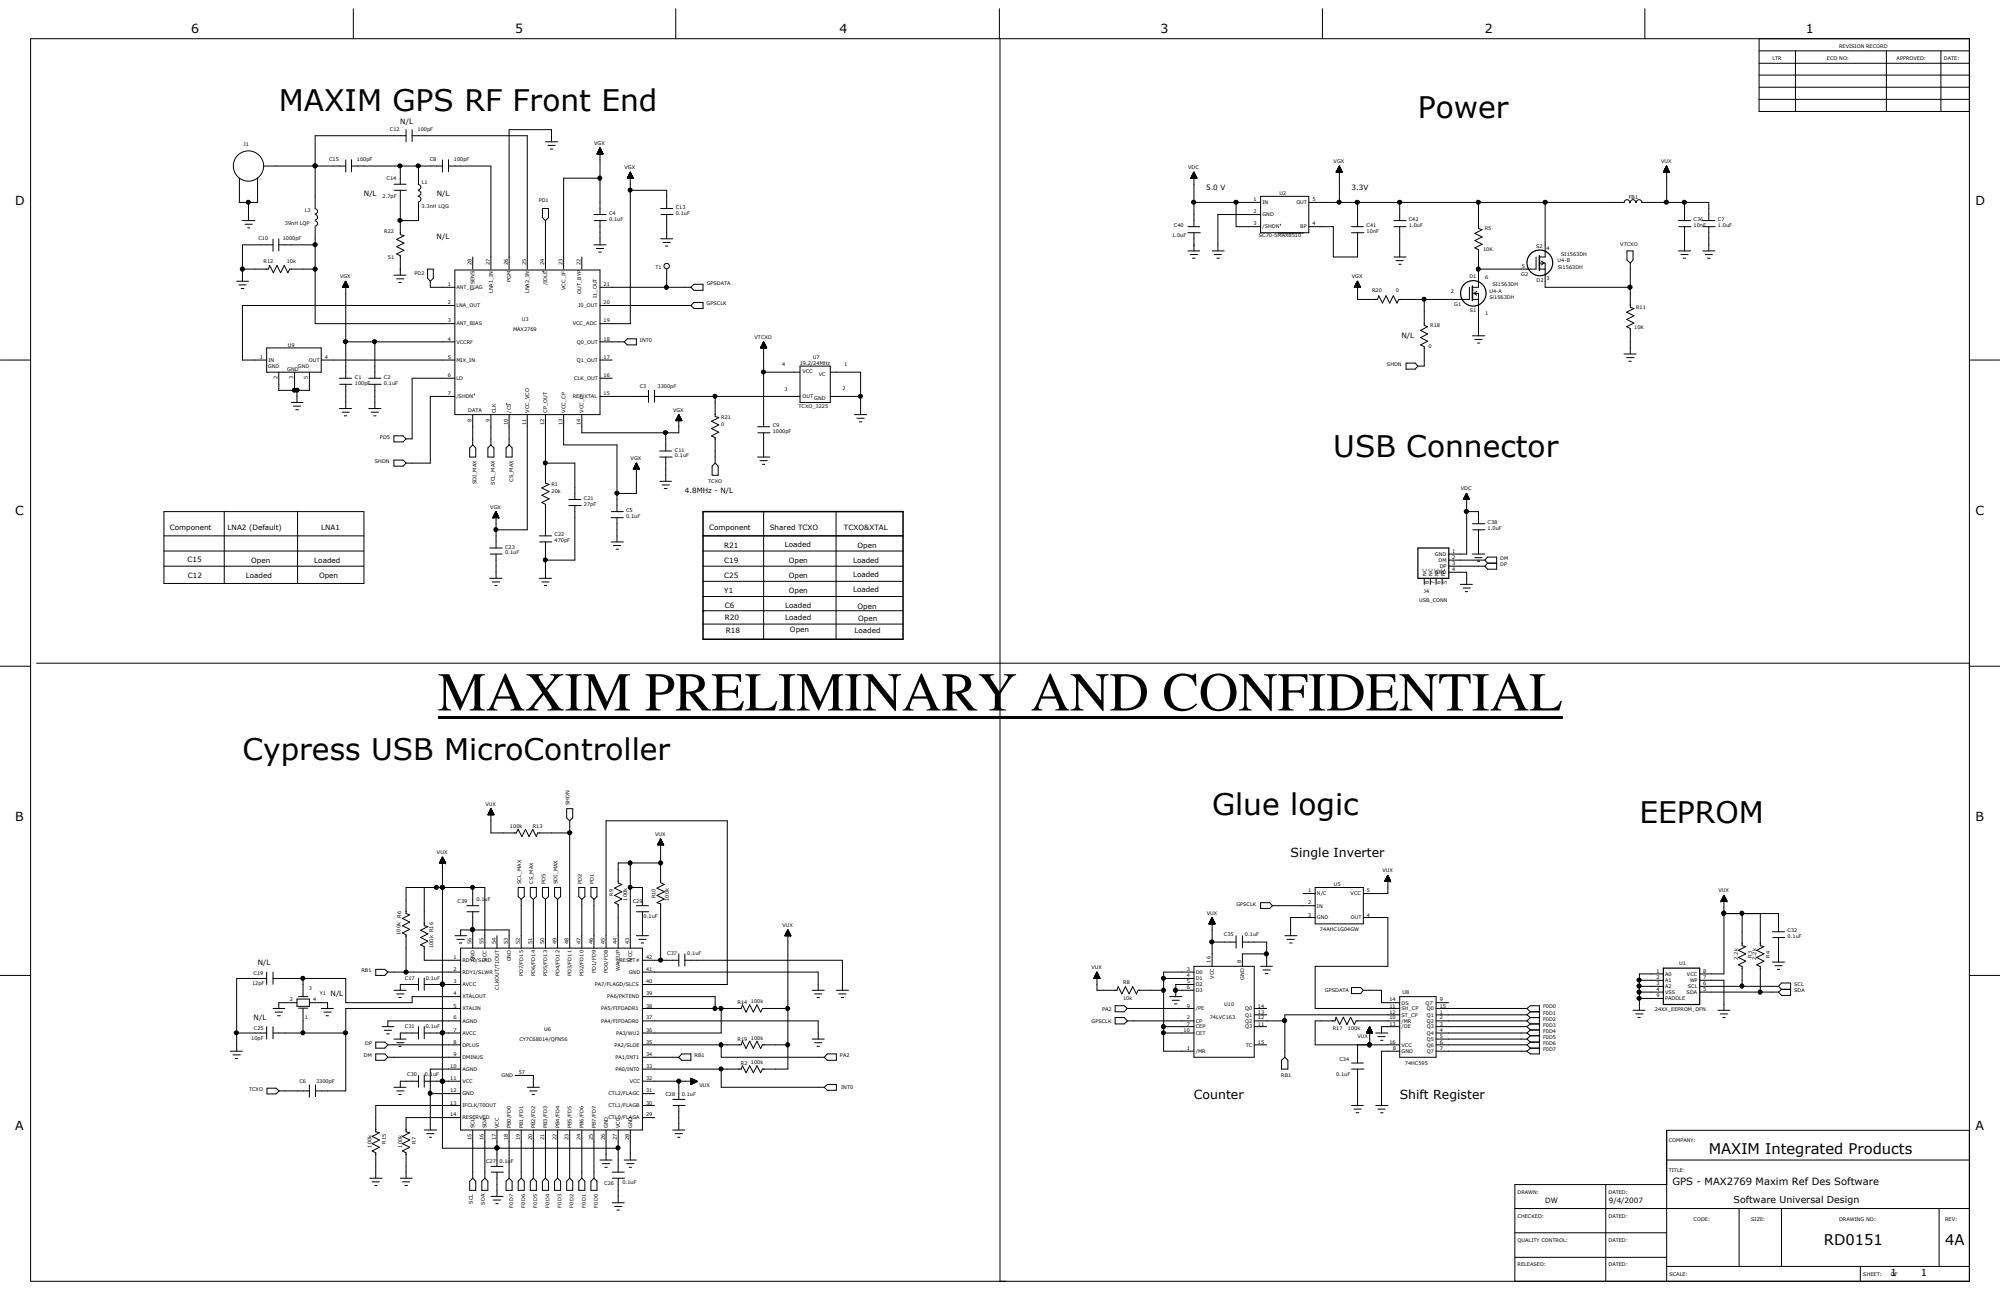
[picture p140: page 1]

MAXIM GPS RF Front End N/L | VGX | REVISION RECORD

LTR | ECO NO: | APPROVED: | DATE:

C6 | Loaded | Open
R20 | Loaded | Open
R18 | Open | Loaded

MAXIM PRELIMINARY AND CONFIDENTIAL

11 VCC | 32 VCC

12 GND | 31 CTL2/FLAGC

TITLE:
GPS - MAX2769 Maxim Ref Des Software

DRAWN: DW | DATED: 9/4/2007

CHECKED: | DATED: | CODE: | SIZE: | DRAWING NO: RD0151 | REV: 4A

QUALITY CONTROL: | DATED:

RELEASED: | DATED:

SCALE: | 1 1 SHEET: OF
