lyf8118/sandiaproject/Docs/CDs/Utah 2008-09/MSP430/slac027a/D169_dac12_01.c

//*******************************************************************************
//  D169 Demo - DAC12.1 Output 2V on P6.7  
//
//  Description; Using DAC12.1 and 2.5V ADC12REF reference with a gain of 1, 
//  ouput 2V on P6.7. Ouput accuracy is specified by that of the ADC12REF.
//
//               MSP430F169
//            -----------------
//        /|\|              XIN|-  
//         | |                 |
//         --|RST          XOUT|-
//           |                 |
//           |        DAC1/P6.7|--> 2V
//           |                 |
//
//  M.Buccini
//  Texas Instruments, Inc
//  August 2003
//  Built with IAR Embedded Workbench Version: 1.26B
//******************************************************************************

#include  <msp430x16x.h>

void main(void)
{ 
  WDTCTL = WDTPW + WDTHOLD;                       // Stop watchdog
  ADC12CTL0 = REF2_5V + REFON;                    // Internal 2.5V ref on 
  DAC12_1CTL = DAC12IR + DAC12AMP_5 + DAC12ENC;   // Internal ref gain 1
  DAC12_1DAT = 0x0CCC;                            // 2V

  _BIS_SR(LPM4_bits);                             // Enter LPM0 
}
