lyf8118/sandiaproject/Docs/MSP430F5529 items/F552x_C_Code_Examples/F552x_IAR&CCE_C_Code_Examples/MSP430F552x_PortMap_03.c

//******************************************************************************
// MSP430x552x Demo - Port Map single function to multiple pins;
//		Multiple runtime configurations
//
// Description:  The port mapping of TIMERB0 is changed with each WDT interrupt.
//               TimerB0 provides 4 PWMs with 4 different duty cycles.
//               TimerB0 is sourced from ACLK.  ACLK is REFO, 32kHz
//                                                       
//                 MSP430x631x
//             ------------------------                        
//         /|\|                        |                       
//          | |                        |                       
//          --|RST                     |                                   
//            |     P4.0(TB0CCR1,2,3,4)|--> 25,50,75,87.5%                 
//            |     P4.1(TB0CCR1,2,3,4)|--> 25,50,75,87.5%                
//            |     P4.2(TB0CCR1,2,3,4)|--> 25,50,75,87.5%                
//            |     P4.3(TB0CCR1,2,3,4)|--> 25,50,75,87.5%                  
//            |     P4.4(TB0CCR1,2,3,4)|--> 25,50,75,87.5%                  
//            |     P4.5(TB0CCR1,2,3,4)|--> 25,50,75,87.5%                 
//            |     P4.6(TB0CCR1,2,3,4)|--> 25,50,75,87.5%                  
//            |     P4.7(TB0CCR1,2,3,4)|--> 25,50,75,87.5%                  
//                 
//   C.Sterzik/B.Nisarga
//   Texas Instruments Inc.
//   April 2009
//   Built with CCE v3.1 and IAR Embedded Workbench Version: 4.20
//******************************************************************************
#include  "msp430x552x.h"

#define PORT_MAP_RECFG                      // Multiple runtime Port Map configurations

const unsigned char PortSequence[4] = {   PM_TB0CCR1A,
                                          PM_TB0CCR2A,
                                          PM_TB0CCR3A,  
                                          PM_TB0CCR4A };

unsigned char count=0;
void Port_Mapping(void);

void main(void)
{
  WDTCTL = WDTPW + WDTHOLD;                 // Stop WDT
  Port_Mapping();
  // Setup Port Pins              
  P4DIR |= 0xFF;                            // P4.0 - P4.7 output
  P4SEL |= 0xFF;                            // P4.0 - P4.6 Port Map functions
  
  // Setup TB0 
  TB0CCR0 = 256;                            // PWM Period/2
  TB0CCTL1 = OUTMOD_6;                      // CCR1 toggle/set
  TB0CCR1 = 192;                            // CCR1 PWM duty cycle
  TB0CCTL2 = OUTMOD_6;                      // CCR2 toggle/set
  TB0CCR2 = 128;                            // CCR2 PWM duty cycle
  TB0CCTL3 = OUTMOD_6;                      // CCR3 toggle/set
  TB0CCR3 = 64;                             // CCR3 PWM duty cycle
  TB0CCTL4 = OUTMOD_6;                      // CCR4 toggle/set
  TB0CCR4 = 32;                             // CCR4 PWM duty cycle  
  TB0CTL = TBSSEL_1 + MC_3;                 // ACLK, up-down mode
  
// Setup WDT in interval mode                                                 
  WDTCTL = WDT_ADLY_1000;                   // WDT 1s, ACLK, interval timer
  SFRIE1 |= WDTIE;                          // Enable WDT interrupt

  while(1)
  {
    __bis_SR_register(LPM3_bits + GIE);       // Enter LPM3 w/interrupt
    __no_operation();                         // For debugger
    
    Port_Mapping();
    count++;
    if(count==4)
      count = 0; 
  }
}

// Watchdog Timer interrupt service routine
#pragma vector = WDT_VECTOR
__interrupt void watchdog_timer(void)
{
  __bic_SR_register_on_exit(LPM3_bits);   // Exit LPM3

}

void Port_Mapping(void)
{
  unsigned char i;
  volatile unsigned char *ptr;
  __disable_interrupt();                    // Disable Interrupts before altering Port Mapping registers
  PMAPPWD = 0x02D52;                        // Enable Write-access to modify port mapping registers
  
  #ifdef PORT_MAP_RECFG                     
  PMAPCTL = PMAPRECFG;                      // Allow reconfiguration during runtime
  #endif  
  
  ptr = &P4MAP0;
  for(i=0;i<8;i++)
  {
    *ptr = PortSequence[count];
    ptr++;
  }
 
  PMAPPWD = 0;                              // Disable Write-Access to modify port mapping registers
  #ifdef PORT_MAP_EINT
  __enable_interrupt();                     // Re-enable all interrupts
  #endif  
  
}
