lyf8118/sandiaproject/Docs/MSP430F5529 items/F552x_C_Code_Examples/F552x_IAR&CCE_C_Code_Examples/MSP430F552x_uscib0_i2c_08.c

//******************************************************************************
//  MSP430F552x Demo - USCI_B0 I2C Master TX multiple bytes to MSP430 Slave
//
//  Description: This demo connects two MSP430's via the I2C bus. The master
//  transmits to the slave. This is the MASTER CODE. It cntinuously
//  transmits an array of data and demonstrates how to implement an I2C
//  master transmitter sending multiple bytes using the USCI_B0 TX interrupt.
//  ACLK = n/a, MCLK = SMCLK = BRCLK = default DCO = ~1.045MHz
//
//                                /|\  /|\
//                MSP430F5529     10k  10k      MSP430F5529
//                   slave         |    |         master
//             -----------------   |    |   -----------------
//           -|XIN  P3.0/UCB0SDA|<-|----+->|P3.0/UCB0SDA  XIN|-
//            |                 |  |       |                 |
//           -|XOUT             |  |       |             XOUT|-
//            |     P3.1/UCB0SCL|<-+------>|P3.1/UCB0SCL     |
//            |                 |          |                 |
//
//   Bhargavi Nisarga
//   Texas Instruments Inc.
//   April 2009
//   Built with CCE v3.1 and IAR Embedded Workbench Version: 4.20
//******************************************************************************

#include "msp430x552x.h"

unsigned char *PTxData;                     // Pointer to TX data
unsigned char TXByteCtr;

const unsigned char TxData[] =              // Table of data to transmit
{
  0x11,
  0x22,
  0x33,
  0x44,
  0x55
};

void main(void)
{
  unsigned int i;

  WDTCTL = WDTPW + WDTHOLD;                 // Stop WDT
  P3SEL |= 0x03;                            // Assign I2C pins to USCI_B0
  UCB0CTL1 |= UCSWRST;                      // Enable SW reset
  UCB0CTL0 = UCMST + UCMODE_3 + UCSYNC;     // I2C Master, synchronous mode
  UCB0CTL1 = UCSSEL_2 + UCSWRST;            // Use SMCLK, keep SW reset
  UCB0BR0 = 12;                             // fSCL = SMCLK/12 = ~100kHz
  UCB0BR1 = 0;
  UCB0I2CSA = 0x48;                         // Slave Address is 048h
  UCB0CTL1 &= ~UCSWRST;                     // Clear SW reset, resume operation
  UCB0IE |= UCTXIE;                         // Enable TX interrupt

  while (1)
  {
    for(i=0;i<10;i++);                      // Delay required between transaction
    PTxData = (unsigned char *)TxData;      // TX array start address
                                            // Place breakpoint here to see each
                                            // transmit operation.
    TXByteCtr = sizeof TxData;              // Load TX byte counter

    UCB0CTL1 |= UCTR + UCTXSTT;             // I2C TX, start condition
    
    __bis_SR_register(LPM0_bits + GIE);     // Enter LPM0, enable interrupts
    __no_operation();                       // Remain in LPM0 until all data
                                            // is TX'd
    while (UCB0CTL1 & UCTXSTP);             // Ensure stop condition got sent
  }
}

//------------------------------------------------------------------------------
// The USCIAB0TX_ISR is structured such that it can be used to transmit any
// number of bytes by pre-loading TXByteCtr with the byte count. Also, TXData
// points to the next byte to transmit.
//------------------------------------------------------------------------------
#pragma vector = USCI_B0_VECTOR
__interrupt void USCI_B0_ISR(void)
{
  switch(__even_in_range(UCB0IV,12))
  {
  case  0: break;                           // Vector  0: No interrupts
  case  2: break;                           // Vector  2: ALIFG
  case  4: break;                           // Vector  4: NACKIFG
  case  6: break;                           // Vector  6: STTIFG
  case  8: break;                           // Vector  8: STPIFG
  case 10: break;                           // Vector 10: RXIFG
  case 12:                                  // Vector 12: TXIFG  
    if (TXByteCtr)                          // Check TX byte counter
    {
      UCB0TXBUF = *PTxData++;               // Load TX buffer
      TXByteCtr--;                          // Decrement TX byte counter
    }
    else
    {
      UCB0CTL1 |= UCTXSTP;                  // I2C stop condition
      UCB0IFG &= ~UCTXIFG;                  // Clear USCI_B0 TX int flag
      __bic_SR_register_on_exit(LPM0_bits); // Exit LPM0
    }  
  default: break;
  }
}
