lyf8118/sandiaproject/Docs/MSP430F5529 items/F552x_C_Code_Examples/F552x_IAR&CCE_C_Code_Examples/MSP430F552x_ta0_16.c

//*******************************************************************************
//  MSP430F552x Demo - Timer0_A5, PWM TA1.1-2, Up Mode, DCO SMCLK
//
//  Description: This program generates two PWM outputs on P1.2,P1.3 using
//  Timer1_A configured for up mode. The value in CCR0, 512-1, defines the PWM
//  period and the values in CCR1 and CCR2 the PWM duty cycles. Using ~1.045MHz
//  SMCLK as TACLK, the timer period is ~500us with a 75% duty cycle on P1.2
//  and 25% on P1.3.
//  ACLK = n/a, SMCLK = MCLK = TACLK = default DCO ~1.045MHz.
//
//                MSP430F552x
//            -------------------
//        /|\|                   |
//         | |                   |
//         --|RST                |
//           |                   |
//           |         P1.2/TA0.1|--> CCR1 - 75% PWM
//           |         P1.3/TA0.2|--> CCR2 - 25% PWM
//
//   Bhargavi Nisarga
//   Texas Instruments Inc.
//   April 2009
//   Built with CCE v3.1 and IAR Embedded Workbench Version: 4.20
//******************************************************************************

#include  "msp430x552x.h"

void main(void)
{
  WDTCTL = WDTPW + WDTHOLD;                 // Stop WDT
  P1DIR |= BIT2+BIT3;                       // P1.2 and P1.3 output
  P1SEL |= BIT2+BIT3;                       // P1.2 and P1.3 options select
  TA0CCR0 = 512-1;                          // PWM Period
  TA0CCTL1 = OUTMOD_7;                      // CCR1 reset/set
  TA0CCR1 = 384;                            // CCR1 PWM duty cycle
  TA0CCTL2 = OUTMOD_7;                      // CCR2 reset/set
  TA0CCR2 = 128;                            // CCR2 PWM duty cycle
  TA0CTL = TASSEL_2 + MC_1 + TACLR;         // SMCLK, up mode, clear TAR

  __bis_SR_register(LPM0_bits);             // Enter LPM0
  __no_operation();                         // For debugger
}
