lyf8118/sandiaproject/Docs/MSP430F5529 items/F552x_C_Code_Examples/F552x_IAR&CCE_C_Code_Examples/MSP430F552x_ta1_17.c

//*******************************************************************************
//  MSP430F552x Demo - Timer1_A3, PWM TA1.1-2, Up Mode, 32kHz ACLK
//
//  Description: This program generates two PWM outputs on P2.0,P2.1 using
//  Timer1_A configured for up mode. The value in CCR0, 512-1, defines the PWM
//  period and the values in CCR1 and CCR2 the PWM duty cycles. Using 32kHz
//  ACLK as TACLK, the timer period is ~ (512/32k) ~ 15.6ms with a 75% duty
//  cycle on P2.0 and 25% on P2.1. Normal operating mode is LPM3.
//  ACLK = TACLK = LFXT1 = 32768Hz, MCLK = default DCO ~1.045MHz.
//
//                MSP430F552x
//            -------------------
//        /|\|                   |
//         | |                   |
//         --|RST                |
//           |                   |
//           |         P2.0/TA1.1|--> CCR1 - 75% PWM
//           |         P2.1/TA1.2|--> CCR2 - 25% PWM
//
//   Bhargavi Nisarga
//   Texas Instruments Inc.
//   April 2009
//   Built with CCE v3.1 and IAR Embedded Workbench Version: 4.20
//******************************************************************************

#include  "msp430x552x.h"

void main(void)
{
  WDTCTL = WDTPW + WDTHOLD;                 // Stop WDT
  P2DIR |= BIT0+BIT1;                       // P2.0 and P2.1 output
  P2SEL |= BIT0+BIT1;                       // P2.0 and P2.1 options select
  TA1CCR0 = 512-1;                          // PWM Period
  TA1CCTL1 = OUTMOD_7;                      // CCR1 reset/set
  TA1CCR1 = 384;                            // CCR1 PWM duty cycle
  TA1CCTL2 = OUTMOD_7;                      // CCR2 reset/set
  TA1CCR2 = 128;                            // CCR2 PWM duty cycle
  TA1CTL = TASSEL_1 + MC_1 + TACLR;         // ACLK, up mode, clear TAR

  __bis_SR_register(LPM3_bits);             // Enter LPM3
  __no_operation();                         // For debugger
}
