lyf8118/sandiaproject/Docs/MSP430F5529 items/F552x_C_Code_Examples/F552x_IAR&CCE_C_Code_Examples/MSP430F552x_ta2_19.c

//*******************************************************************************
//  MSP430F552x Demo - Timer2_A3, PWM TA1.1-2, Up/Down Mode, DCO SMCLK
//
//  Description: This program generates two PWM outputs on P2.4,5 using
//  Timer1_A configured for up/down mode. The value in CCR0, 128, defines the
//  PWM period/2 and the values in CCR1 and CCR2 the PWM duty cycles. Using
//  ~1.045MHz SMCLK as TACLK, the timer period is ~233us with a 75% duty cycle
//  on P2.4 and 25% on P2.5.
//  SMCLK = MCLK = TACLK = default DCO ~1.045MHz.
//
//                MSP430F552x
//            -------------------
//        /|\|                   |
//         | |                   |
//         --|RST                |
//           |                   |
//           |         P2.4/TA2.1|--> CCR1 - 75% PWM
//           |         P2.5/TA2.2|--> CCR2 - 25% PWM
//
//   Bhargavi Nisarga
//   Texas Instruments Inc.
//   April 2009
//   Built with CCE v3.1 and IAR Embedded Workbench Version: 4.20
//******************************************************************************

#include  "msp430x552x.h"

void main(void)
{
  WDTCTL = WDTPW + WDTHOLD;                 // Stop WDT
  P2DIR |= BIT4+BIT5;                       // P2.4 and P2.5 output
  P2SEL |= BIT4+BIT5;                       // P2.4 and P2.5 options select
  TA2CCR0 = 128;                            // PWM Period/2
  TA2CCTL1 = OUTMOD_6;                      // CCR1 toggle/set
  TA2CCR1 = 32;                             // CCR1 PWM duty cycle
  TA2CCTL2 = OUTMOD_6;                      // CCR2 toggle/set
  TA2CCR2 = 96;                             // CCR2 PWM duty cycle
  TA2CTL = TASSEL_2 + MC_3 + TACLR;         // SMCLK, up-down mode, clear TAR

  __bis_SR_register(LPM0_bits);             // Enter LPM0
  __no_operation();                         // For debugger
}
