lyf8118/sandiaproject/UofU_GPSReceiver/RTC/GUI/USBCDC_Example1/USB_Common/descriptors.h

// (c)2009 by Texas Instruments Incorporated, All Rights Reserved.
/*----------------------------------------------------------------------------+
|                                                                             |
|                              Texas Instruments                              |
|                                                                             |
|                          MSP430 USB-Example (CDC/HID Driver)                |
|                                                                             |
+-----------------------------------------------------------------------------+
|  Source: descriptors.h, v1.12 2009/05/26                                    |
|  Author: Rostyslav Stolyar                                                  |
|                                                                             |
|  WHO          WHEN         WHAT                                             |
|  ---          ----------   ------------------------------------------------ |
|  R.Stolyar    2008/09/03   born                                             |
|  R.Stolyar    2008/11/29   Added global USB constants                       |
|  R.Stolyar    2008/12/23   enhancements of CDC API                          |
|  R.Stolyar    2009/05/25   put all config constants into this file          |
+----------------------------------------------------------------------------*/


/*----------------------------------------------------------------------------+
| Include files                                                               |
+----------------------------------------------------------------------------*/
#include "..\Common\types.h"

//***********************************************************************************************
// CDC or HID
//***********************************************************************************************
#define _CDC_          // Needed for CDC inteface
//#define _HID_          // Needed for HID interface

//***********************************************************************************************
// CONFIGURATION CONSTANTS
//***********************************************************************************************

// These constants configure the API stack and help define the USB descriptors.
// Refer to Sec. 6 of the MSP430 USB CDC API Programmer's Guide for descriptions of these constants.

#define USB_VID 0x2047         // Vendor ID, 0x2047 for Texas Instruments Incorporated (MSP430 Group)

#ifdef _CDC_
    #define USB_PID                         0x0300 // Product ID (PID), 0xF400 for CDC stack
    #define SIZEOF_CONFIGURATION_DESCRIPTOR     53 // wTotalLength, CDC
    #define INTERFACE_NUMBER_CDC                0
    #define CDC_INTEP_ADDR                      0x82
    #define CDC_OUTEP_ADDR                      0x03
    #define CDC_INEP_ADDR                       0x83

    #ifdef _HID_
      #error Only ONE of interfaces should be defined: _HID_ or _CDC_!
    #endif
#else
    #ifdef _HID_
        #define USB_PID                     0x0301 // Product ID (PID), 0xF401 for HID stack
        #define SIZEOF_CONFIGURATION_DESCRIPTOR 41 // wTotalLength, HID
        #define START_HID_DESCRIPTOR            18
        #define INTERFACE_NUMBER_HID            0
        #define HID_OUTEP_ADDR                0x01
        #define HID_INEP_ADDR                 0x81
    #else
        #error No interface HID or CDC defined! Define it.
    #endif
#endif

/*----------------------------------------------------------------------------+
| Firmware Version                                                            |
| How to detect version number of the FW running on MSP430?                   |
| on Windows Open ControlPanel->Systems->Hardware->DeviceManager->Ports->     |
|         Msp430->ApplicationUART->Details                                    |
+----------------------------------------------------------------------------*/
#define VER_FW_H 0x01                       // Device release number -- high and low bytes, in binary-coded decimal
#define VER_FW_L 0x12                       // This is reported in the bcdDevice field of the device descriptor

#define USB_MCLK_FREQ 8000000               // MCLK frequency of MCU, in Hz
#define MAX_PACKET_SIZE   0x40              // Max size of the USB packets.


// If a serial number is to be reported, set this to the index within the string descriptor
// of the dummy serial number string.  It will then be automatically handled by the API.
// If no serial number is to be reported, set this to 0.
#define USB_STR_INDEX_SERNUM 3


#define USB_PLL_XT        2                 // Defines which XT is used by the PLL (1=XT1, 2=XT2)
#define USB_XT_FREQ       USBPLL_SETCLK_4_0 // Indicates the freq of the crystal on the oscillator indicated by USB_PLL_XT
#define USB_DISABLE_XT_SUSPEND 1            // If non-zero, then USB_suspend() will disable the oscillator
                                            // that is designated by USB_PLL_XT; if zero, USB_suspend won't
                                            // affect the oscillator

#define USB_SUPPORT_REM_WAKE     0x20       // If remote wakeup is to be supported, set this to 0x20.  If not, set to 0x00.
                                            // All other values are prohibited.

// Controls whether the device reports itself to be self-powered to any degree.  If so, set to 0x40.  If the
// device is fully supplied by the bus, set to 0x00.  All other values are prohibited.
#define USB_SUPPORT_SELF_POWERED 0x40


// Controls how much power the device reports it will draw from VBUS.  Expressed in 2mA units; that is, the
// number of mA communicated is twice the value of this field.
#define USB_MAX_POWER 0x32


#define USB_DMA_TX   0x1    // Set to 0xFF if no DMA channel will be used 0..7 for selected DMA channel
#define USB_DMA_RX   0x1    // Set to 0xFF if no DMA channel will be used 0..7 for selected DMA channel

#define USB_NUM_CONFIGURATIONS          1  // Number of implemented interfaces.  This is fixed to 1.


//***********************************************************************************************
// DESCRIPTOR CONSTANTS
//***********************************************************************************************
#define SIZEOF_DEVICE_DESCRIPTOR  0x12
#define SIZEOF_REPORT_DESCRIPTOR  36
#define USBHID_REPORT_LENGTH      64  // length of whole HID report (including Report ID)
#define SIZEOF_INTERFACE_DESCRIPTOR 0x09

#define CONFIG_STRING_INDEX       4
#define INTF_STRING_INDEX         5

//***********************************************************************************************
// OUTWARD DECLARATIONS
//***********************************************************************************************

//Calculates the endpoint descriptor block number from given address
#define EDB(addr) ((addr&0x07)-1)

extern BYTE const abromDeviceDescriptor[SIZEOF_DEVICE_DESCRIPTOR];
extern BYTE const abromConfigurationDescriptorGroup[SIZEOF_CONFIGURATION_DESCRIPTOR];
extern BYTE const abromReportDescriptor[SIZEOF_REPORT_DESCRIPTOR];
extern BYTE const abromStringDescriptor[];

/*------------------------ Nothing Below This Line --------------------------*/
