lyf8118/sandiaproject/Docs/MSP430F5529 items/F552x_C_Code_Examples/F552x_IAR&CCE_C_Code_Examples/MSP430F552x_UCS_07.c

//*****************************************************************************
//  MSP430F552x Demo - FLL+, Output 32kHz Xtal + HF Xtal + Internal DCO
//
//  Description:  This program demonstrates using an external 32kHz crystal to
//  supply ACLK, and using a high speed crystal or resonator to supply SMCLK.
//  MLCK for the CPU is supplied by the internal DCO.  The 32kHz crystal
//  connects between pins Xin and Xout. The high frequency crystal or
//  resonator connects between pins XT2IN and XT2OUT.  The DCO clock is
//  generated internally and calibrated from the 32kHz crystal.  
//  ACLK is rought out on pin P1.0, SMCLK is brought out on P2.2, and MCLK
//  is brought out on pin P7.7.
//  ACLK = LFXT1 = 32768Hz, MCLK = default DCO = 32 x ACLK = 1048576Hz
//  SMCLK = HF XTAL
//  //* An external watch crystal between XIN & XOUT is required for ACLK *//	
//
//  NOTE: External matching capacitors must be added for the high
//       speed crystal or resonator as required.
//
//                MSP430F552x
//             -----------------
//        /|\ |              XIN|-
//         |  |                 | 32kHz
//         ---|RST          XOUT|-
//            |                 |
//            |                 |
//            |            XT2IN|-
//            |                 | HF XTAL or Resonator (add capacitors)
//            |           XT2OUT|-
//            |                 |
//            |             P1.0|--> ACLK = 32kHz Crystal Out
//            |                 |
//            |             P2.2|--> SMCLK = High Freq Xtal or Resonator Out
//            |                 |
//            |             P7.7|--> MCLK = Default DCO Frequency
//            |                 |
//            |                 |
//
//   Bhargavi Nisarga
//   Texas Instruments Inc.
//   April 2009
//   Built with CCE v3.1 and IAR Embedded Workbench Version: 4.20
//******************************************************************************

#include  "msp430x552x.h"

void main(void)
{
  WDTCTL = WDTPW + WDTHOLD;                 // Stop WDT

  P1DIR |= BIT0;                            // ACLK set out to pins
  P1SEL |= BIT0;                            
  P2DIR |= BIT2;                            // SMCLK set out to pins
  P2SEL |= BIT2;                            
  P7DIR |= BIT7;                            // MCLK set out to pins
  P7SEL |= BIT7;
  
  P5SEL |= BIT2+BIT3;                       // Port select XT2
  P5SEL |= BIT4+BIT5;                       // Port select XT1

  UCSCTL6 &= ~XT2OFF;                       // Set XT2 On
  UCSCTL6 |= XCAP_3;                        // Internal load cap

  // XT1 is by default on as it is used default reference for the FLL - internal load caps?
  // Loop until XT1,XT2 & DCO stabilizes
  do
  {
    UCSCTL7 &= ~(XT2OFFG + XT1LFOFFG + XT1HFOFFG + DCOFFG);
                                            // Clear XT2,XT1,DCO fault flags
    SFRIFG1 &= ~OFIFG;                      // Clear fault flags
  }while (SFRIFG1&OFIFG);                   // Test oscillator fault flag

  UCSCTL6 &= ~XT2DRIVE0;                    // Decrease XT2 Drive according to
                                            // expected frequency  
  UCSCTL4 |= SELA_0 + SELS_5;               // Select SMCLK, ACLK source and DCO source

  while(1);                                 // Loop in place
}
