lyf8118/sandiaproject/Docs/MSP430F5529 items/F552x_C_Code_Examples/F552x_IAR&CCE_C_Code_Examples/MSP430F552x_flashwrite_03.c

//******************************************************************************
//  MSP430F552x Demo - Bank Erase from a Block while Executing Code from Another
//                    Block.
//
//  Description: This program first writes to Bank 1 from 0x10000 to 0x10100.
//  Then a bank erase is done on Bank 1. During Bank erase, code is still
//  executing from Bank 0 by toggling P1.0. Toggling can only be seen by using
//  an oscilloscope.
//  Ensure Large memory model is selected.
//  ACLK = REFO = 32kHz, MCLK = SMCLK = default DCO 1048576Hz
//  //* Set Breakpoint on NOP in the Mainloop to avoid Stressing Flash *//
//
//               MSP430F552x
//            -----------------
//        /|\|              XIN|-
//         | |                 |
//         --|RST          XOUT|-
//           |                 |
//           |             P1.0|- Oscilloscope
//
//   Bhargavi Nisarga
//   Texas Instruments Inc.
//   April 2009
//   Built with CCE v3.1 and IAR Embedded Workbench Version: 4.20
//******************************************************************************

#include "msp430x552x.h"

// Function prototypes
void erase_Seg(void);
void wrt_Bank1(void);

char value;                                 // 8-bit value to write to Bank 1

void main(void)
{
  WDTCTL = WDTPW+WDTHOLD;                   // Stop WDT

  P1DIR |= 0x01;                            // Set P1.0 as output
  while(1)
  {
    P1OUT &= ~ 0x01;                        // clear P1.0
    value = 0;                              // Loop forever, SET BREAKPOINT HERE
    wrt_Bank1();                            // Write to Bank 1
    erase_Seg();                            // Call erase function
    while(BUSY & FCTL3)                     // Check for erase completion
    {
      P1OUT ^= 0x01;                        // toggle LED if still erasing
    }                                       // Else, Exit if erase is done
  }
}

//------------------------------------------------------------------------------
// Erases Memory Bank 1
//------------------------------------------------------------------------------
void erase_Seg(void)
{
  char *Flash_ptr = (char *)0x10000;        // Initialize Flash pointer
  FCTL3 = FWKEY;                            // Clear Lock bit
  FCTL1 = FWKEY+MERAS;                      // Set Bank Erase bit
  *Flash_ptr = 0;                           // Dummy erase byte
  FCTL3 = FWKEY+LOCK;                       // Set LOCK bit
}

//------------------------------------------------------------------------------
// Writes incremented Value to Bank 1
//------------------------------------------------------------------------------
void wrt_Bank1(void)
{
  unsigned int i;
  char *Flash_ptr = (char *)0x10000;        // Initialize Flash pointer

  FCTL3 = FWKEY;                            // Clear Lock bit
  FCTL1 = FWKEY+WRT;                        // Set WRT bit for write operation
  for(i = 0; i < 256; i++)
  {
    *Flash_ptr++ = value++;                   // Write a word to flash
  }
  FCTL1 = FWKEY;                            // Clear WRT bit
  FCTL3 = FWKEY+LOCK;                       // Set LOCK bit
}
