lyf8118/sandiaproject/UofU_GPSReceiver/RTC/GUI/USBCDC_Example1/USBCDC_constructs.h

BYTE sendData_waitTilDone(BYTE* dataBuf, WORD size, BYTE intfNum, ULONG ulTimeout);
BYTE sendData_inBackground(BYTE* dataBuf, WORD size, BYTE intfNum, ULONG ulTimeout);
BYTE receiveData_waitTilDone(BYTE* dataBuf, WORD size, BYTE intfNum, ULONG ulTimeout);
WORD receiveDataInBuffer(BYTE*,WORD,BYTE);
