lyf8118/sandiaproject/Docs/MSP430F5529 items/F552x_C_Code_Examples/F552x_IAR&CCE_C_Code_Examples/MSP430F552x_LPM3_01.c

//******************************************************************************
//   MSP430x552x Demo - Enters LPM3 with ACLK = LFXT1, REF0 disabled, 
//                      VUSB LDO and SLDO disabled, SVS disabled
//
//   Description: Configure ACLK = LFXT1 and enters LPM3. Measure current.
//   ACLK = LFXT1 = 32kHz, MCLK = SMCLK = default DCO
//
//                MSP430F552x
//             -----------------
//        /|\ |              XIN|-
//         |  |                 | 32kHz
//         ---|RST          XOUT|-
//            |                 |
//
//   Bhargavi Nisarga
//   Texas Instruments Inc.
//   April 2009
//   Built with CCE v3.1 and IAR Embedded Workbench Version: 4.20
//******************************************************************************
#include  "msp430x552x.h"

void main(void)
{
  WDTCTL = WDTPW + WDTHOLD;                 // Stop watchdog timer
  
  // Enable XT1
  P5SEL |= BIT4+BIT5;                       // Port select XT1
  UCSCTL6 &= ~(XT1OFF);                     // XT1 On
  UCSCTL6 |= XCAP_3;                        // Internal load cap

  // Loop until XT1 & DCO stabilizes
  do
  {
    UCSCTL7 &= ~(XT2OFFG + XT1LFOFFG + XT1HFOFFG + DCOFFG);
                                            // Clear XT2,XT1,DCO fault flags
    SFRIFG1 &= ~OFIFG;                      // Clear fault flags
  }while (SFRIFG1&OFIFG);                   // Test oscillator fault flag

  UCSCTL6 &= ~(XT1DRIVE_3);                 // Xtal is now stable, reduce drive
                                            // strength
  // Port Configuration
  P1OUT = 0x00;P2OUT = 0x00;P3OUT = 0x00;P4OUT = 0x00;P5OUT = 0x00;P6OUT = 0x00;
  P7OUT = 0x00;P8OUT = 0x00;PJOUT = 0x00;
  P1DIR = 0xFF;P2DIR = 0xFF;P3DIR = 0xFF;P4DIR = 0xFF;P5DIR = 0xFF;P6DIR = 0xFF;
  P7DIR = 0xFF;P8DIR = 0xFF;PJDIR = 0xFF;

  // Disable VUSB LDO and SLDO
  USBKEYPID   =     0x9628;           // set USB KEYandPID to 0x9628 
                                      // access to USB config registers enabled  
  USBPWRCTL &= ~(SLDOEN+VUSBEN);      // Disable the VUSB LDO and the SLDO
  USBKEYPID   =    0x9600;            // access to USB config registers disabled  

  // Disable SVS
  PMMCTL0_H = PMMPW_H;                // PMM Password
  SVSMHCTL &= ~(SVMHE+SVSHE);         // Disable High side SVS 
  SVSMLCTL &= ~(SVMLE+SVSLE);         // Disable Low side SVS
  
  __bis_SR_register(LPM3_bits);       // Enter LPM3
  __no_operation();                   // For debugger
}
