lyf8118/sandiaproject/Docs/MSP430F5529 items/F552x_C_Code_Examples/F552x_IAR&CCE_C_Code_Examples/MSP430F552x_MPY_01.c

//******************************************************************************
//    MSP430F552x Demo - 16x16 Unsigned Multiply
//
//   Description: Hardware multiplier is used to multiply two numbers.
//   The calculation is automatically initiated after the second operand is
//   loaded. Results are stored in RESLO and RESHI.
//
//   ACLK = 32.768kHz, MCLK = SMCLK = default DCO
//
//                MSP430F552x
//             -----------------
//         /|\|                 |
//          | |                 |
//          --|RST              |
//            |                 |
//            |                 |
//
//   Bhargavi Nisarga
//   Texas Instruments Inc.
//   April 2009
//   Built with CCE v3.1 and IAR Embedded Workbench Version: 4.20
//******************************************************************************

#include  "msp430x552x.h"

void main(void)
{
  WDTCTL = WDTPW+WDTHOLD;                   // Stop WDT

  MPY = 0x1234;                             // Load first operand -unsigned mult
  OP2 = 0x5678;                             // Load second operand
  
  __bis_SR_register(LPM4_bits);             // Enter LPM4 
  __no_operation();                         // For debugger  
}
