lyf8118/sandiaproject/Docs/MSP430F5529 items/F552x_C_Code_Examples/F552x_IAR&CCE_C_Code_Examples/MSP430F552x_MPY_06.c

//******************************************************************************
//   MSP430F552x Demo - 8x8 Unsigned Multiply Accumulate
//
//   Description: Hardware multiplier is used to multiply two numbers.
//   The calculation is automatically initiated after the second operand is
//   loaded. A second multiply accumulate operation is performed after that.
//   Results are stored in RESLO and RESHI. SUMEXT contains the carry of the
//   result.
//
//               MSP430F552x
//             -----------------
//         /|\|                 |
//          | |                 |
//          --|RST              |
//            |                 |
//            |                 |
//
//   Bhargavi Nisarga
//   Texas Instruments Inc.
//   April 2009
//   Built with CCE v3.1 and IAR Embedded Workbench Version: 4.20
//******************************************************************************

#include  "msp430x552x.h"

void main(void)
{
  WDTCTL = WDTPW+WDTHOLD;                   // Stop WDT

  MPY = 0x12;                               // Load first operand -unsigned mult
  OP2 = 0x56;                               // Load second operand

  MAC = 0x12;                               // Load first operand -unsigned MAC
  OP2 = 0x56;                               // Load second operand

  __bis_SR_register(LPM4_bits);             // Enter LPM4
  __no_operation();                         // For debugger  
}
