lyf8118/sandiaproject/Docs/MSP430F5529 items/F552x_C_Code_Examples/F552x_IAR&CCE_C_Code_Examples/MSP430F552x_MPY_11.c

//******************************************************************************
//  MSP430F552x Demo - 32x32 Signed Multiply Accumalate
//
//  Description: Hardware multiplier is used to multiply-accumalate a set of
//  numbers. The first calculation is automatically initiated after the second
//  operand is loaded. A second multiply-accumulate operation is performed next.
//  Results are stored in RES0, RES1, RES2 and RES3.
//  SUMEXT contains the extended sign of the result.
//
//   ACLK = 32.768kHz, MCLK = SMCLK = default DCO
//
//                MSP430F552x
//             -----------------
//         /|\|                 |
//          | |                 |
//          --|RST              |
//            |                 |
//            |                 |
//
//   Bhargavi Nisarga
//   Texas Instruments Inc.
//   April 2009
//   Built with CCE v3.1 and IAR Embedded Workbench Version: 4.20
//******************************************************************************

#include  "msp430x552x.h"

void main(void)
{
  WDTCTL = WDTPW+WDTHOLD;                   // Stop WDT

                                            // unsigned multiply
  MPY32L = 0x1234;                          // Load lower 16 bits of operand 1
  MPY32H = 0x1234;                          // Load upper 16 bits of operand 1

  OP2L = 0x5678;                            // Load lower 16 bits of operand 2
  OP2H = 0x5678;                            // Load upper 16 bits of operand 2
                                            // signed MAC
  MACS32L = 0x1234;                         // Load lower 16 bits of operand 1
  MACS32H = 0x1234;                         // Load upper 16 bits of operand 1

  OP2L = 0x5678;                            // Load lower 16 bits of operand 2
  OP2H = 0x5678;                            // Load upper 16 bits of operand 2

  __bis_SR_register(LPM4_bits);             // Enter LPM4
  __no_operation();                         // For debugger
}
