lyf8118/sandiaproject/Docs/MSP430F5529 items/F552x_C_Code_Examples/F552x_IAR&CCE_C_Code_Examples/MSP430F552x_MPY_15.c

//******************************************************************************
//   MSP430F552x Demo - Fractional mode, Q15 multiplication
//
//   Description: The example illustrates multiplication of 2 Q15 numbers in
//   fractional mode. The result is a Q15 (15 bit) number stored in the RES1
//   register. It can be viewed in the debugger window.
//
//
//   ACLK = 32.768kHz, MCLK = SMCLK = default DCO
//
//                MSP430F552x
//             -----------------
//         /|\|                 |
//          | |                 |
//          --|RST              |
//            |                 |
//            |                 |
//
//   Bhargavi Nisarga
//   Texas Instruments Inc.
//   April 2009
//   Built with CCE v3.1 and IAR Embedded Workbench Version: 4.20
//******************************************************************************

#include  "msp430x552x.h"

unsigned int Result_Q15;

void main(void)
{
  WDTCTL = WDTPW+WDTHOLD;                   // Stop WDT

  MPY32CTL0 = MPYFRAC;                      // Set fractional mode

  MPYS = 0x7D70;                            // Load first operand
  OP2 = 0x1000;                             // Load second operand

  Result_Q15 = RESHI;                       // Q15 result

  MPY32CTL0 &= ~MPYFRAC;
  
  __bis_SR_register(LPM4_bits);             // Enter LPM4
  __no_operation();                         // For debugger
}
