lyf8118/sandiaproject/Docs/MSP430F5529 items/F552x_C_Code_Examples/F552x_IAR&CCE_C_Code_Examples/MSP430F552x_P1_02.c

//******************************************************************************
//  MSP430F552x Demo - Software Port Interrupt Service on P1.4 from LPM4 with
//                    Internal Pull-up Resistance Enabled
//
//  Description: A hi "TO" low transition on P1.4 will trigger P1_ISR which,
//  toggles P1.0. P1.4 is internally enabled to pull-up. Normal mode is
//  LPM4 ~ 0.1uA. LPM4 current can be measured with the LED removed, all
//  unused Px.x configured as output or inputs pulled high or low.
//  ACLK = n/a, MCLK = SMCLK = default DCO
//
//               MSP430F552x
//            -----------------
//        /|\|              XIN|-
//         | |                 |
//         --|RST          XOUT|-
//     /|\   |                 |
//      --o--|P1.4         P1.0|-->LED
//     \|/
//
//   Bhargavi Nisarga
//   Texas Instruments Inc.
//   April 2009
//   Built with CCE v3.1 and IAR Embedded Workbench Version: 4.20
//******************************************************************************

#include  "msp430x552x.h"

void main(void)
{
  WDTCTL = WDTPW + WDTHOLD;                 // Stop watchdog timer
  P1DIR |= BIT0;                            // Set P1.0 to output direction
  P1REN |= BIT4;                            // Enable P1.4 internal resistance
  P1OUT |= BIT4;                            // Set P1.4 as pull-Up resistance
  P1IES |= BIT4;                            // P1.4 Hi/Lo edge
  P1IFG &= ~BIT4;                           // P1.4 IFG cleared
  P1IE |= BIT4;                             // P1.4 interrupt enabled
  
  __bis_SR_register(LPM4_bits + GIE);       // Enter LPM4 w/interrupt
  __no_operation();                         // For debugger
}

// Port 1 interrupt service routine
#pragma vector=PORT1_VECTOR
__interrupt void Port_1(void)
{
  P1OUT ^= BIT0;                            // P1.0 = toggle
  P1IFG &= ~BIT4;                          // P1.4 IFG cleared
}
