lyf8118/sandiaproject/Docs/MSP430F5529 items/F552x_C_Code_Examples/F552x_IAR&CCE_C_Code_Examples/MSP430F552x_PB_05.c

//******************************************************************************
//   MSP430TC0701 Demo - Write a Word to Port B (Port3+Port4)
//
//   Description: Writes a Word(1234h) to Port B and stays in LPM4
//   ACLK = 32.768kHz, MCLK = SMCLK = default DCO
//
//               MSP430TC0701
//             -----------------
//         /|\|                 |
//          | |                 |
//          --|RST              |
//            |                 |
//            |                 |
//
//   Bhargavi Nisarga
//   Texas Instruments Inc.
//   April 2009
//   Built with CCE v3.1 and IAR Embedded Workbench Version: 4.20
//******************************************************************************

#include  "msp430x552x.h"

void main(void)
{
  WDTCTL = WDTPW+WDTHOLD;                   // Stop WDT

  PBDIR |= 0x0FFFF;                         // PB.x output
  PBOUT = 0x1234;                           // Write to PortB

  __bis_SR_register(LPM4_bits + GIE);     // Enter LPM4 w/interrupt
  __no_operation();                         // Place BREAKPOINT HERE and check register PBOUT, P3OUT and P4OUT
}
