lyf8118/sandiaproject/Docs/MSP430F5529 items/F552x_C_Code_Examples/F552x_IAR&CCE_C_Code_Examples/MSP430F552x_UCS_05.c

//******************************************************************************
//  MSP430F552x Demo - VLO sources ACLK
//
//  Description: This program demonstrates using VLO to source ACLK
//  ACLK = VLO = 9.4kHz (typical)
//
//                 MSP430F552x
//             -----------------
//         /|\|                 |
//          | |                 |
//          --|RST              |
//            |                 |
//            |             P1.0|-->ACLK = ~12kHz
//            |                 |
//
//   Bhargavi Nisarga
//   Texas Instruments Inc.
//   April 2009
//   Built with CCE v3.1 and IAR Embedded Workbench Version: 4.20
//******************************************************************************

#include  "msp430x552x.h"

void main(void)
{
  WDTCTL = WDTPW + WDTHOLD;                 // Stop watchdog timer
  UCSCTL4 |= SELA_1;                        // VLO Clock Sources ACLK

  P1DIR |= BIT0;                            // ACLK set out to pin
  P1SEL |= BIT0;

  __bis_SR_register(LPM3_bits);             // Enter LPM3
  __no_operation();                         // For debugger  
}
