lyf8118/sandiaproject/Docs/MSP430F5529 items/F552x_C_Code_Examples/F552x_IAR&CCE_C_Code_Examples/MSP430F552x_WDT_04.c

//******************************************************************************
//  MSP430F552x Demo - WDT+ Failsafe Clock, WDT mode, DCO SMCLK
//
//  Description; Allow WDT+ in watchdog mode to timeout. Toggle P1.0 in main
//  function. LPM4 is entered, this example will demonstrate WDT+ feature
//  of preventing WDT+ clock to be disabled.
//  The WDT+ will not allow active WDT+ clock to be disabled by software, the
//  LED continues to Flash because the WDT times out normally (in 32768 DCOCLK
//  cycles) even though software has attempted to disable WDT+ clock source.
//  ACLK = n/a, MCLK = SMCLK = default DCO ~1.045MHz
//
//                MSP430F552x
//             -----------------
//         /|\|                 |
//          | |                 |
//          --|RST              |
//            |                 |
//            |             P1.0|-->LED
//
//   Bhargavi Nisarga
//   Texas Instruments Inc.
//   April 2009
//   Built with CCE v3.1 and IAR Embedded Workbench Version: 4.20
//******************************************************************************

#include  "msp430x552x.h"

void main(void)
{
  P1DIR |= 0x01;                            // Set P1.0 to output - SET BREAKPOINT HERE
  P1OUT ^= 0x01;                            // Toggle P1.0
  
  __bis_SR_register(LPM4_bits + GIE);       // Enter LPM4, Stop all clocks
  __no_operation();                         // For debugger  
}
