lyf8118/sandiaproject/Docs/MSP430F5529 items/F552x_C_Code_Examples/F552x_IAR&CCE_C_Code_Examples/MSP430F552x_WDT_06.c

//******************************************************************************
//  MSP430TC0701 Demo - WDT+ Failsafe Clock, 32kHz ACLK
//
//  Description; Allow WDT+ in watchdog to timeout sourced by ACLK. LPM3 is
//  entered, this example will demonstrate WDT+ feature by automatically
//  re-enabling WDT+ clock source as DCO if external XTAL fails. This can be
//  seen as a continued, though faster as clocked by DCO, watchdog timeout
//  which will toggle on P1.0 in main function.
//  ACLK = 32768, MCLK = SMCLK = default DCO ~1.045MHz
//
//                MSP430TC0701
//             -----------------
//         /|\|                 |
//          | |                 |
//          --|RST              |
//            |                 |
//            |             P1.0|-->LED
//
//   Bhargavi Nisarga
//   Texas Instruments Inc.
//   April 2009
//   Built with CCE v3.1 and IAR Embedded Workbench Version: 4.20
//******************************************************************************

#include  "msp430x552x.h"

void main(void)
{
  // Watchdog mode -> reset after expired time; WDT is clocked by ACLK
  WDTCTL = WDT_ARST_1000;                   // Set Watchdog Timer timeout 1s - SET BREAKPOINT HERE
  P1DIR |= 0x01;                            // Set P1.0 to output
  P1OUT ^= 0x01;                            // Toggle P1.0
  
  __bis_SR_register(LPM3_bits + GIE);       // Enter LPM3
  __no_operation();                         // For debugger
  
}
