lyf8118/sandiaproject/Docs/MSP430F5529 items/F552x_C_Code_Examples/F552x_IAR&CCE_C_Code_Examples/MSP430F552x_ta0_02.c

//******************************************************************************
//  MSP430F552x Demo - Timer0_A5, Toggle P1.0, CCR0 Up Mode ISR, DCO SMCLK
//
//  Description: Toggle P1.0 using software and TA_1 ISR. Timer1_A is
//  configured for up mode, thus the timer overflows when TAR counts
//  to CCR0. In this example, CCR0 is loaded with 50000.
//  ACLK = n/a, MCLK = SMCLK = TACLK = default DCO ~1.045MHz
//
//           MSP430F552x
//         ---------------
//     /|\|               |
//      | |               |
//      --|RST            |
//        |               |
//        |           P1.0|-->LED
//
//   Bhargavi Nisarga
//   Texas Instruments Inc.
//   April 2009
//   Built with CCE v3.1 and IAR Embedded Workbench Version: 4.20
//******************************************************************************

#include  "msp430x552x.h"

void main(void)
{
  WDTCTL = WDTPW + WDTHOLD;                 // Stop WDT
  P1DIR |= 0x01;                            // P1.0 output
  TA0CCTL0 = CCIE;                          // CCR0 interrupt enabled
  TA0CCR0 = 50000;
  TA0CTL = TASSEL_2 + MC_1 + TACLR;         // SMCLK, upmode, clear TAR

  __bis_SR_register(LPM0_bits + GIE);       // Enter LPM0, enable interrupts
  __no_operation();                         // For debugger
}

// Timer0 A0 interrupt service routine
#pragma vector=TIMER0_A0_VECTOR
__interrupt void TIMER0_A0_ISR(void)
{
  P1OUT ^= 0x01;                            // Toggle P1.0
}
