lyf8118/sandiaproject/Docs/MSP430F5529 items/F552x_C_Code_Examples/F552x_IAR&CCE_C_Code_Examples/MSP430F552x_ta0_04.c

//******************************************************************************
//  MSP430F552x Demo - Timer0_A5, Toggle P1.0, Overflow ISR, 32kHz ACLK
//
//  Description: Toggle P1.0 using software and the Timer0_A overflow ISR.
//  In this example an ISR triggers when TA overflows. Inside the ISR P1.0
//  is toggled. Toggle rate is exactly 0.5Hz. Proper use of the TAIV interrupt
//  vector generator is demonstrated.
//  ACLK = TACLK = 32768Hz, MCLK = SMCLK = default DCO ~1.045MHz
//
//           MSP430F552x
//         ---------------
//     /|\|               |
//      | |               |
//      --|RST            |
//        |               |
//        |           P1.0|-->LED
//
//   Bhargavi Nisarga
//   Texas Instruments Inc.
//   April 2009
//   Built with CCE v3.1 and IAR Embedded Workbench Version: 4.20
//******************************************************************************

#include  "msp430x552x.h"

void main(void)
{
  WDTCTL = WDTPW + WDTHOLD;                 // Stop WDT
  P1DIR |= 0x01;                            // P1.0 output
  TA0CTL = TASSEL_1 + MC_2 + TACLR + TAIE;  // ACLK, contmode, clear TAR
                                            // enable interrupt

  __bis_SR_register(LPM3_bits + GIE);       // Enter LPM3, enable interrupts
  __no_operation();                         // For debugger
}

// Timer0_A5 Interrupt Vector (TAIV) handler
#pragma vector=TIMER0_A1_VECTOR
__interrupt void TIMER0_A1_ISR(void)
{
  switch(__even_in_range(TA0IV,14))
  {
    case  0: break;                          // No interrupt
    case  2: break;                          // CCR1 not used
    case  4: break;                          // CCR2 not used
    case  6: break;                          // reserved
    case  8: break;                          // reserved
    case 10: break;                          // reserved
    case 12: break;                          // reserved
    case 14: P1OUT ^= 0x01;                  // overflow
             break;
    default: break; 
  }
}
