lyf8118/sandiaproject/Docs/MSP430F5529 items/F552x_C_Code_Examples/F552x_IAR&CCE_C_Code_Examples/MSP430F552x_ta1_01.c

//******************************************************************************
//  MSP430F552x Demo - Timer1_A3, Toggle P1.0, CCR0 Cont. Mode ISR, DCO SMCLK
//
//  Description: Toggle P1.0 using software and TA_1 ISR. Toggles every
//  50000 SMCLK cycles. SMCLK provides clock source for TACLK.
//  During the TA_1 ISR, P1.0 is toggled and 50000 clock cycles are added to
//  CCR0. TA_1 ISR is triggered every 50000 cycles. CPU is normally off and
//  used only during TA_ISR.
//  ACLK = n/a, MCLK = SMCLK = TACLK = default DCO ~1.045MHz
//
//           MSP430F552x
//         ---------------
//     /|\|               |
//      | |               |
//      --|RST            |
//        |               |
//        |           P1.0|-->LED
//
//   Bhargavi Nisarga
//   Texas Instruments Inc.
//   April 2009
//   Built with CCE v3.1 and IAR Embedded Workbench Version: 4.20
//******************************************************************************

#include  "msp430x552x.h"

void main(void)
{
  WDTCTL = WDTPW + WDTHOLD;                 // Stop WDT
  P1DIR |= 0x01;                            // P1.0 output
  TA1CCTL0 = CCIE;                          // CCR0 interrupt enabled
  TA1CCR0 = 50000;
  TA1CTL = TASSEL_2 + MC_2 + TACLR;         // SMCLK, contmode, clear TAR

  __bis_SR_register(LPM0_bits + GIE);       // Enter LPM0, enable interrupts
  __no_operation();                         // For debugger
}

// Timer1 interrupt service routine
#pragma vector=TIMER1_A0_VECTOR
__interrupt void TIMER1_A0_ISR(void)
{
  P1OUT ^= 0x01;                            // Toggle P1.0
  TA1CCR0 += 50000;                         // Add Offset to CCR0
}
