lyf8118/sandiaproject/(commit log)

2009-09-18 Add code samples from last year.
2009-09-29 Adding powerpoint from Preliminary Design Review and created folder for misc Docs.
2009-10-02 New datasheets for GNSS receiver SE4120L and evaluation board (USB) as well as a breakout board I am trying very hard to acquire.
2009-10-08 Adding accelerometer code.
2009-10-09 Updated Prototype BOM.xls Added Eagle CAD protype schematics
    [Prototype BOM.xls, board.sch]
2009-10-15 Experimented with accelerometer test code
2009-10-22 Trying again with part1.
    [BOM.xlsx, Parts.xlsx, board centroid.csv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]
2009-10-23 Updated: Schematics: prototypes/main/ Docs/Prototype BOM.xls
    Changes:
    Schematics:
    -Added passive 1st order LPFs to accelerometer output
    -Reorganized schematics for easier reading
    -Added pin header ports to SiGe SE4120L, MCU, MUX, & accelerometer PWR
    -Added pin header port for RTC
    Prototype BOM.xls:
    -Updated to show received parts (designated by check mark)
    [Prototype BOM.xls, board.sch]
2009-10-29 submit accelerometer code we played with today.
2009-10-30 Updated: /prototypes/main/* /Docs/Prototype BOM.xls
    [Prototype BOM.xls, board.brd, board.sch]
2009-10-31 Added new processor to BOM
    [Prototype BOM.xls]
2009-11-01 Added: libraries/mylib.lbr (Eagle libraries with Micron flash) prototypes/flash breakout/ (breakout board design for Micron flash) Updated: prototypes/main/ (schematics and stripboard layout)
    [board.brd, board.sch]
2009-11-10 Updated: Prototype BOM.xls - Reorganized - Added flash breakout PCB
    Added: Report/Prototypes.doc (prototype section of the report)
    [Prototype BOM.xls]
2009-11-10 Updated: prototypes/flash breakout/*
    - Routed rev1 using min. 5mil traces
    Added: prototypes/flash breakout/rev2 (flash breakout board using blind vias)
    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
    [board.brd, board.sch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]
2009-11-10 Adding working A/D Low power code.
2009-11-10 Weekly report and final agenda (Agenda 10 November 2009.doc). Commented timer_ad_conv_LPM3_code.c
2009-11-17 Add ADC stuff for the 5529.
2009-11-17 Adding last of what I had from the old processor with ADC stuff and such.
2009-11-17 ADC code so far.
2009-11-17 More ADC stuff.
2009-11-19 Saving code at the end of the day. The accelerometer works now!
2009-12-01 Updated: CAD/prototypes/main Added: CAD/prototypes/mux
    Schematics and board layout for new mux
    [board.brd, board.sch]
2009-12-01 added my piece to the power point
2009-12-03 Updated: /CAD/prototypes/mux/* Added: /December Presentation/prototypes/*.png (pictures for presentation)
    [board.brd, board.sch]
2010-01-08 Added: Eagle schematics: main PCB
    Updated: mux/board
    [board.sch]
2010-02-09 sorry it didn't add everything before.
    [main.c]
2010-03-03 RTC finished i think. it should now give an interrupt every minute.
2010-03-06 Fixing usb compile error in main project.
    [UGPS.h, usb.h]
2010-03-10 Changed pulse counter code to an external wakeup pin. This will eventually be renamed.
2010-03-12 adding pin info, changing external pin to P2.0
2010-03-17 Turn external pin off after LPM3 exit plus other comments.
2010-03-22 made changes to make the RTC work and set up ways to set the time and get the time. also set ways to set which interrupt you would like to use. need to test the changes i made.
2010-03-23 Made RTC interrupt work.
2010-04-05 Editing ADC code. Need to end a repeated sequence of channels conversion properly by disabling the ADC converter.
